okinawa-ai-beach-robot/beach-cleaning-hardware/components/gripper/Flexible robotic gripper/servo_spec.webp

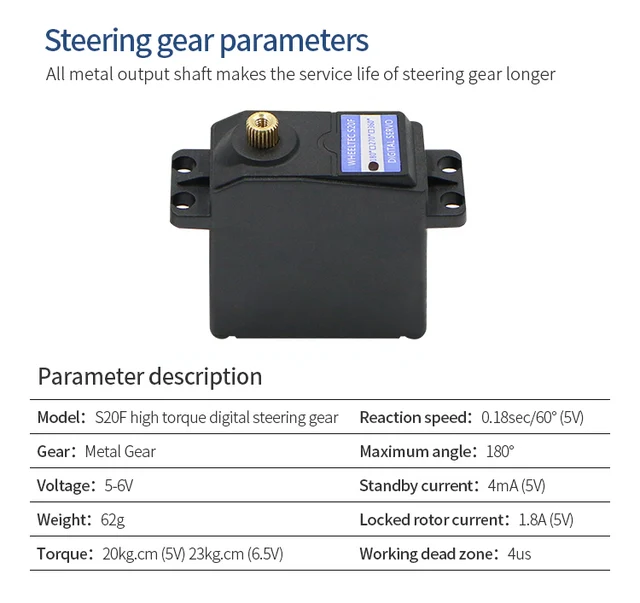
components/gripper/Flexible robotic gripper/servo_spec.webp
