okinawa-ai-beach-robot/beach-cleaning-hardware/components/gripper/Flexible robotic gripper/Steering machine version electronic control description.jpg

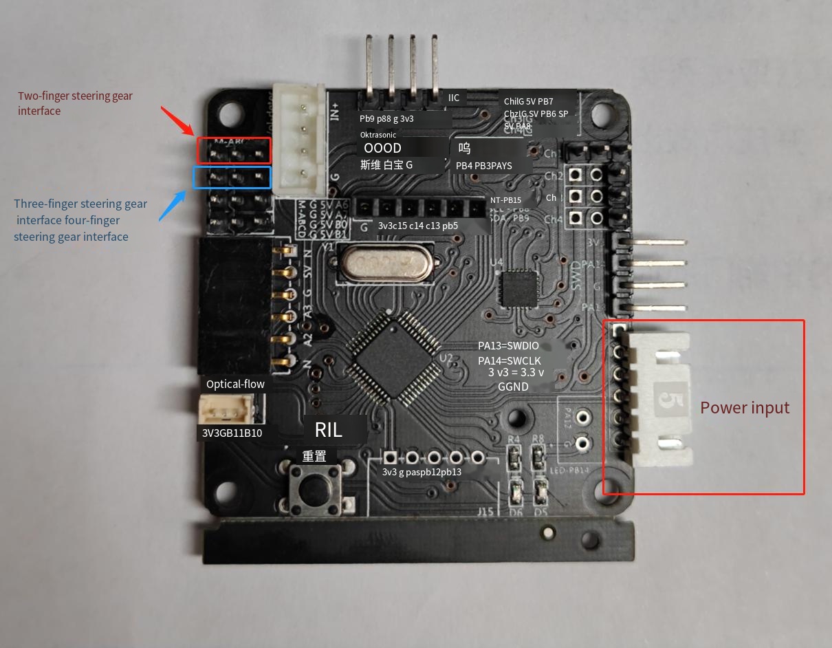
components/gripper/Flexible robotic gripper/Steering machine version electronic control description.jpg
