okinawa-ai-beach-robot/beach-cleaning-hardware/components/gripper/servointerface/digispark_intf_platformio/README.md

# Interface: Servo PWM to inflateable gripper

- This project simulates a servo input and generates motor signals for the inflatable gripper
- Project is made for a Digistump board
- For reference see comments in: [source file](src/digispark_intf.cpp)
- Open with PlatformIO (vscode plugin)
