okinawa-ai-beach-robot/beach-cleaning-hardware/components/arm_RoArm-M1/roarm-m1-custom-firmware/angleinfo.txt

config pose:
{"A1":179.6484375,"T1":-32,"A2":74.0625,"T2":64,"A3":-5.361328125,"T3":48,"A4":0.703125,"T4":-64,"A5":68.46679688,"T5":0}

Joint control init pose:
{"A1":179.7363281,"T1":-32,"A2":0.17578125,"T2":56,"A3":90.17578125,"T3":24,"A4":89.03320313,"T4":96,"A5":68.90625,"T5":0}
