okinawa-ai-beach-robot/beach-cleaning-hardware/components/arm_RoArm-M1/RoArm-M1-Waveshare-Wiki.pdf

RoArm-M

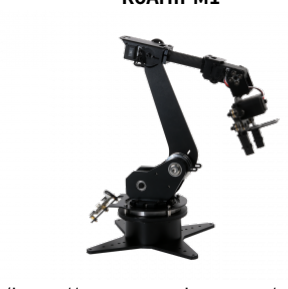
[picture p4: figure]

(https://www.waveshare.com/roarm-m.htm) (https://www.waveshare.com/roarm-m1.htm)

TTL serial bus servo control interface, UART

# RoArm-M

From Waveshare Wiki
Jump to: navigation, (https://www.waveshare.com/wiki/RoArm-M1#mw-navigation) search (https://www.waveshare.com/wiki/RoArm-M1#p-search)

## Introduction

RoArm-M is a mechanical arm based on the ESP series structure, including the clamping freedom of the gripper. This product has a total of degrees of freedom, all of which are driven by a kg.cm high-torque ST serial bus servo. Each servo can feed back the current joint voltage, position, current, temperature, load, and other information. And the big arm adopts a : reduction group with timing pulleys, which greatly improves the effective torque of the mechanical arm on the one hand, and can be used to avoid damage to structural parts caused by excessive loads on the other hand.

Onboard WIFI, OLED screen, RGB-LED lights, and open source all product-related codes, including the underlying serial bus servo control function library, serial communication control functions, cross-platform WEB control functions, inverse kinematics, ROS demos, URDF models, etc.

The demo contains a variety of control methods: angle control mode, inverse kinematics coordinate control mode, recording action and
replaying action, and leading-following control mode based on ESP-NOW communication protocol.

RoArm-M can support a variety of host computers, as long as it is connected to the host computer via a USB cable. The host computer can be a PC, Raspberry Pi, Jetson Nano, or other devices, and the data in JSON format can be sent and received via the USB serial port to control the robotic arm or get feedback from a robotic arm.

## Features

- RoArm-M is a serial robotic arm with -DOF in total, including the clamping freedom of the gripper.
- Open-source demo includes angle control and coordinates control.
- The lower computer demo contains open source inverse kinematics algorithm.
- Supports leading-following mode based on ESP-NOW.
- Supports motion recording and replaying control mode.
- Based on ESP, supports WIFI and UART communication.
- The open-source demos include WEB applications that can be used across platforms. You only need to install a browser to use mobile phones, tablets, and computers to control the robotic arm.
- Supports multiple host computers, and provides ROS demo and other rich learning resources.
- Cameras can be installed on the gripper of the robotic arm.
- All codes are open-source, and we provide rich online development documents and tutorials.

## Video

- RoArm-M show:

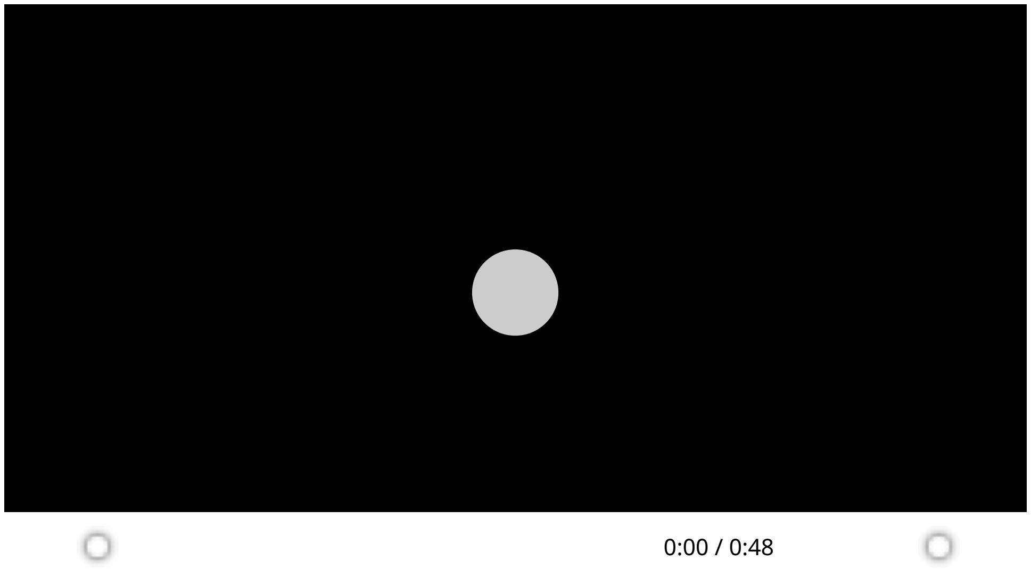
[picture p5: figure]

## RoArm-M Tutorial Directory

Please be sure to understand the following before use:
. This product has been assembled before leaving the factory, but due to the use of a large number of servos, once it is disassembled and then reassembled, it must be assembled and calibrated according to the product assembly tutorial.
. The torque of the servos used in this product is relatively large, so it may bring potential risks. When using it, keep sensitive parts such as eyes away from the range of motion of the servos, and keep them away from children to avoid injury.
. Some joints use green nitrile rubber O-rings to eliminate the virtual position error and vibration of the joints. It is normal for some rubber debris to fall off during use, and it will not continue to shed debris after it is run in.
. For the sake of safety, the robot arm of the default demo runs at a relatively slow speed. You can refer to the secondary development tutorial to change this speed. Too low speed may cause the robot arm to vibrate when it moves to some specific positions.
- RoArm-M Tutorial I: How To Use (/wiki/RoArm-M_Tutorial_I:_How_To_Use) (https://www.waveshare.com/wiki/RoArm-M1_Tutorial_I:_How_To_Use)
- RoArm-M Tutorial II: Secondary Development Tutorial (/wiki/RoArm-M_Tutorial_II:_Secondary_Development_Tutorial) (https://www.waveshare.com/wiki/RoArm-M1_Tutorial_II:_Secondary_Development_Tutorial)
- RoArm-M Tutorial III: VMware ROS Getting Started Tutorial (/wiki/RoArm-M_Tutorial_III:_VMware_ROS_Getting_Started_Tutorial) (https://www.waveshare.com/wiki/RoArm-M1_Tutorial_III:_VMware_ROS2_Getting_Started_Tutorial)
- RoArm-M Tutorial IV: URDF Model Tutorial (/wiki/RoArm-M_Tutorial_IV:_URDF_Model_Tutorial) (https://www.waveshare.com/wiki/RoArm-M1_Tutorial_IV:_URDF_Model_Tutorial)
- RoArm-M Tutorial V: ROS Serial Communication Node (/wiki/RoArm-M_Tutorial_V:_ROS_Serial_Communication_Node) (https://www.waveshare.com/wiki/RoArm-M1_Tutorial_V:_ROS2_Serial_Communication_Node)
- RoArm-M Tutorial VI: How to assemble RoArm-M (/wiki/RoArm-M_Tutorial_VI:_How_to_assemble_RoArm-M) (https://www.waveshare.com/wiki/RoArm-M1_Tutorial_VI:_How_to_assemble_RoArm-M1)
- RoArm-M Tutorial VII: Assembly Graphics Tutorial (/wiki/RoArm-M_Tutorial_VII:_Assembly_Graphics_Tutorial) (https://www.waveshare.com/wiki/RoArm-M1_Tutorial_VII:_Assembly_Graphics_Tutorial)
- RoArm-M Tutorial VIII: Use of rqt in ROS (/wiki/RoArm-M_Tutorial_VIII:_Use_of_rqt_in_ROS) (https://www.waveshare.com/wiki/RoArm-M1_Tutorial_VIII:_Use_of_rqt_in_ROS2)

- RoArm-M Tutorial IV: URDF Model Tutorial (/wiki/RoArm-M_Tutorial_IV:_URDF_Model_Tutorial) (https://www.waveshare.com/wiki/RoArm-M1_Tutorial_IV:_URDF_Model_Tutorial)
- RoArm-M Main Page

# Resource

## Drawing

- Dimensions (https://files.waveshare.com/upload/b/bf/RoArm-M_%E%B%BA%E%AF%B%E%B%BE.pdf)

## VirtualBox ROS Image

- VirtualBox ROS Image (https://drive.google.com/file/d/FDYaLkfqjxyAmPAcw-Qp/view?usp=sharing) (https://drive.google.com/file/d/1F0D1201YaLkf1q8jxy54Am72PAcw8-Qp/view?usp=sharing)
- Password: roarm

## URDF Open Source Model

- URDF Open Source Model (https://files.waveshare.com/upload//b/Roarm_urdf.zip) (https://files.waveshare.com/upload/1/1b/Roarm_urdf.zip)

## STEP Model

- STEP Model (https://files.waveshare.com/upload//a/RoArm-M_STEP.zip) (https://files.waveshare.com/upload/4/4a/RoArm-M1_STEP.zip)

## ROS Package

- ROS Package (https://files.waveshare.com/upload/f/fb/Roarm_ws.zip)

## Slave Device Open-source Demo

- Slave Device Open-source Demo (https://files.waveshare.com/upload//a/RoArm-M-ESP.zip) (https://files.waveshare.com/upload/4/4a/RoArm-M1-ESP32.zip)

## Open-source Resource

- .inch OLED Module Schematic (https://files.waveshare.com/upload//a/.inch_OLED_Module_Schematic.pdf) (https://files.waveshare.com/upload/2/2a/0.91inch_OLED_Module_Schematic.pdf)

# FAQ

Question:. During the installation process of ROS, there are many dependent libraries that cannot be downloaded? (https://www.waveshare.com/wiki/RoArm-M1#accordion1)

Answer:
You can refer to our tutorial to download the image file that has been configured with ROS.

Question:. Logitech mouse wheel not working in a virtual machine? (https://www.waveshare.com/wiki/RoArm-M1#accordion2)

Answer:
Open the Logitech mouse software and turn off smooth scrolling.

Question:. RViz display abnormal? (https://www.waveshare.com/wiki/RoArm-M1#accordion3)

Answer:
Turn off VMware's D graphics acceleration function.

Question:. After the virtual machine is powered on, there is only a terminal interface without a graphical interface? (https://www.waveshare.com/wiki/RoArm-M1#accordion4)

Answer:
Run sudo apt install ubuntu-desktop in the terminal, and sudo reboot to restart the virtual machine after the installation is complete.

# Support
