okinawa-ai-beach-robot/beach-cleaning-hardware/components/gripper/Flexible robotic gripper/Flexible adaptive gripper FA series.pdf

# Flexible adaptive gripper FA series brochure

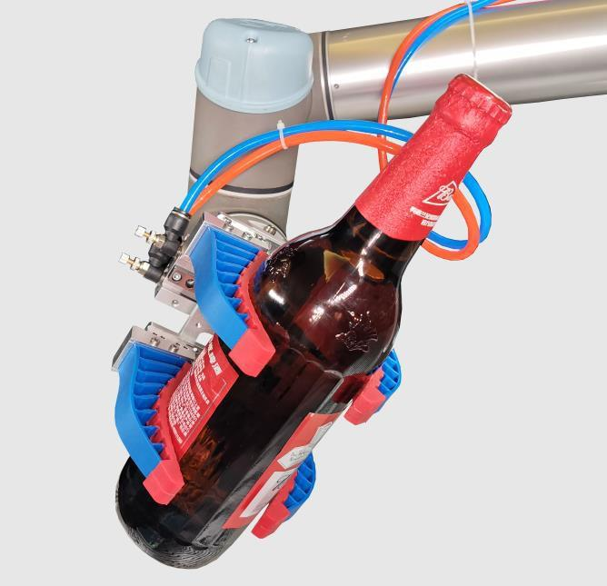
[picture p6: figure]

# Flexible adaptive gripper FA series introduce

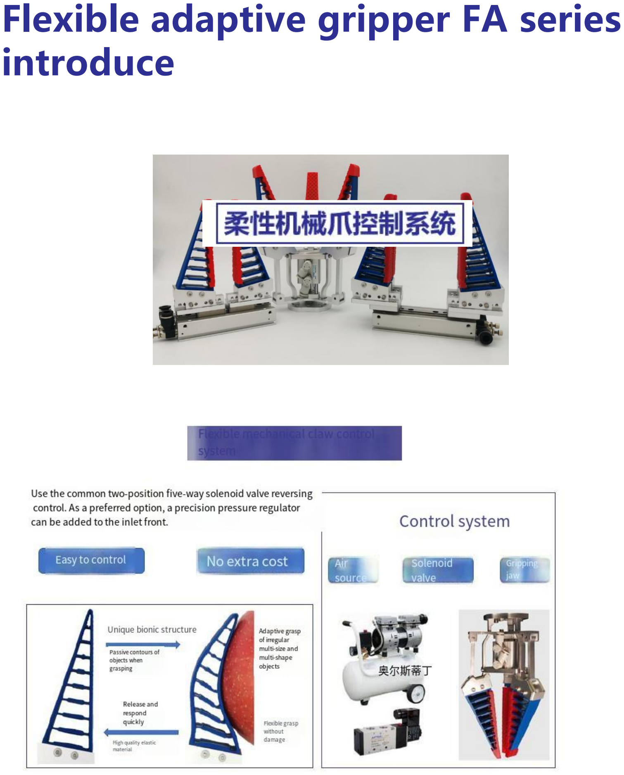
[picture p7: page 2]
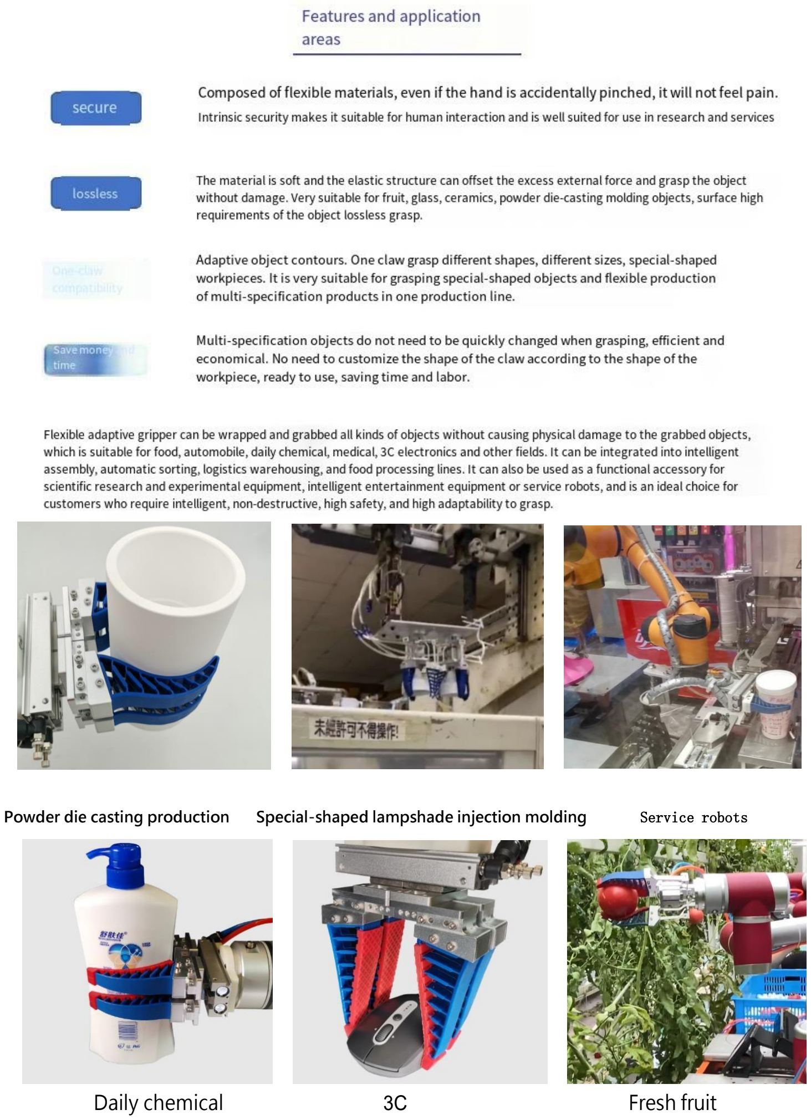
[picture p8: page 3]

Powder die casting production | Special-shaped lampshade injection molding | Service robots
Daily chemical | 3C | Fresh fruit

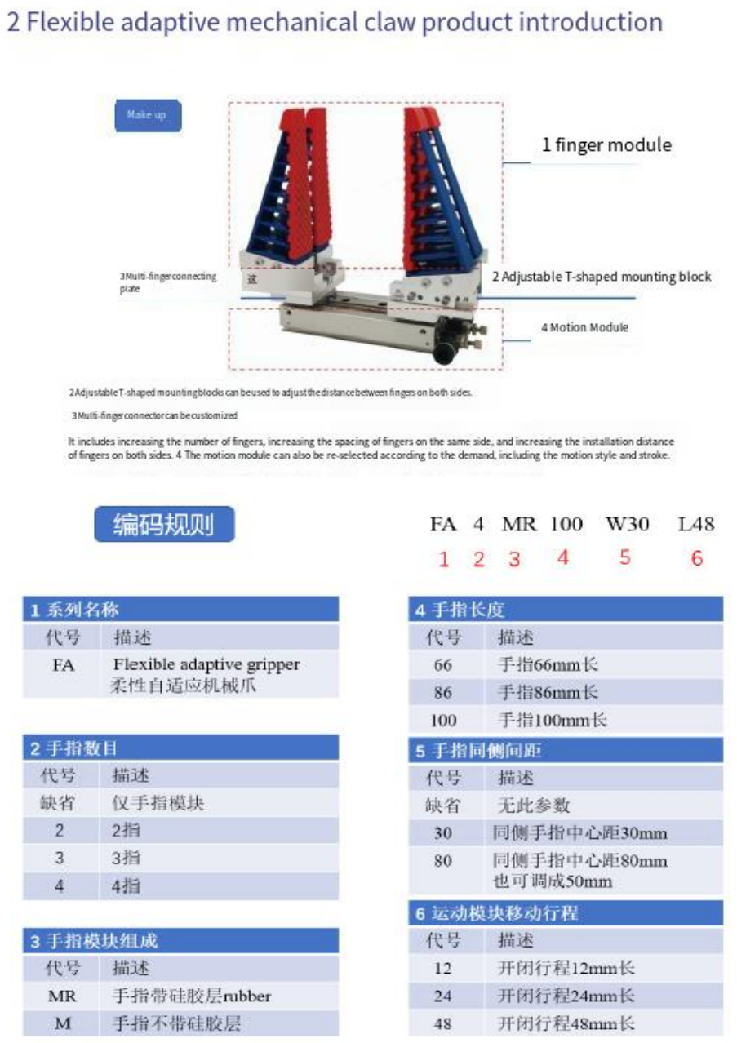
[picture p9: page 4]
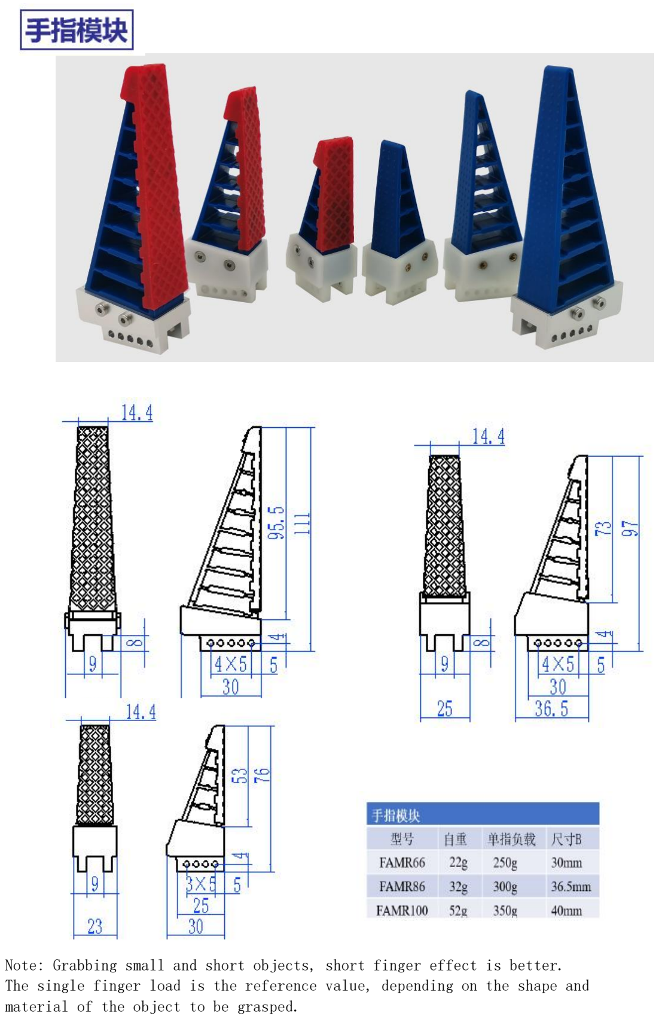
[picture p10: page 5]

Note: Grabbing small and short objects, short finger effect is better. The single finger load is the reference value, depending on the shape and material of the object to be grasped.

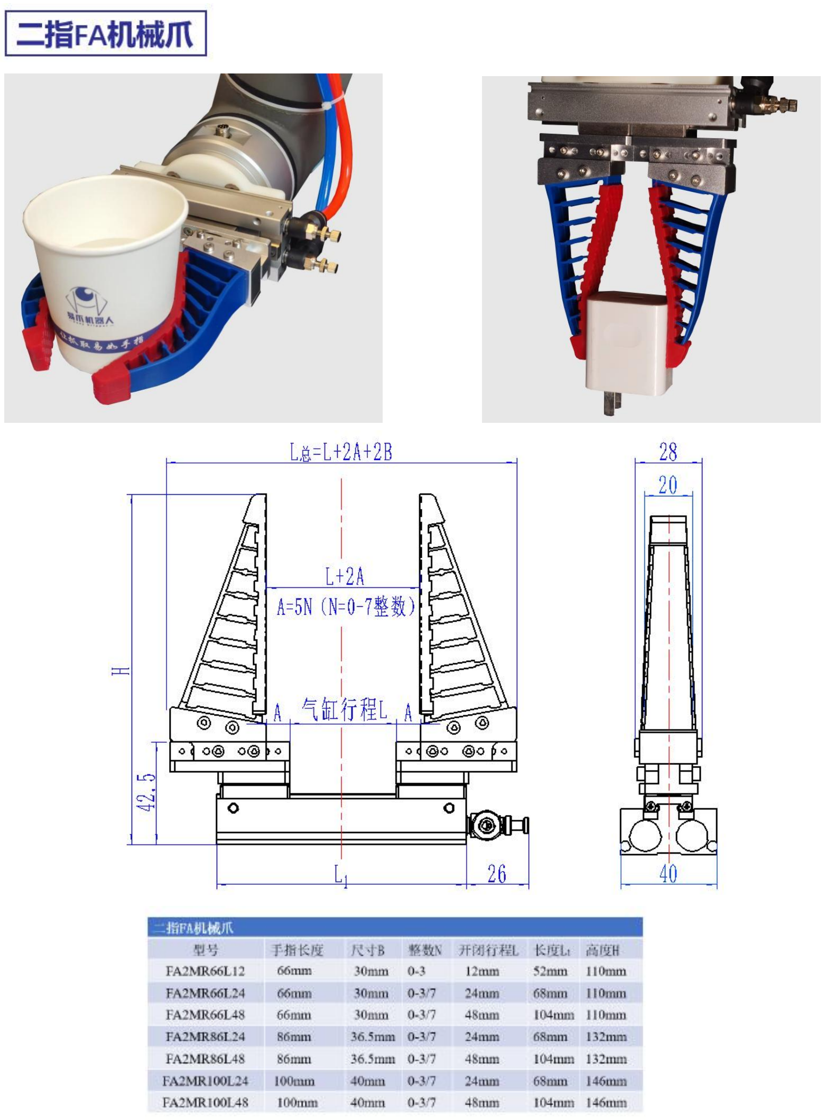
[picture p11: page 6]
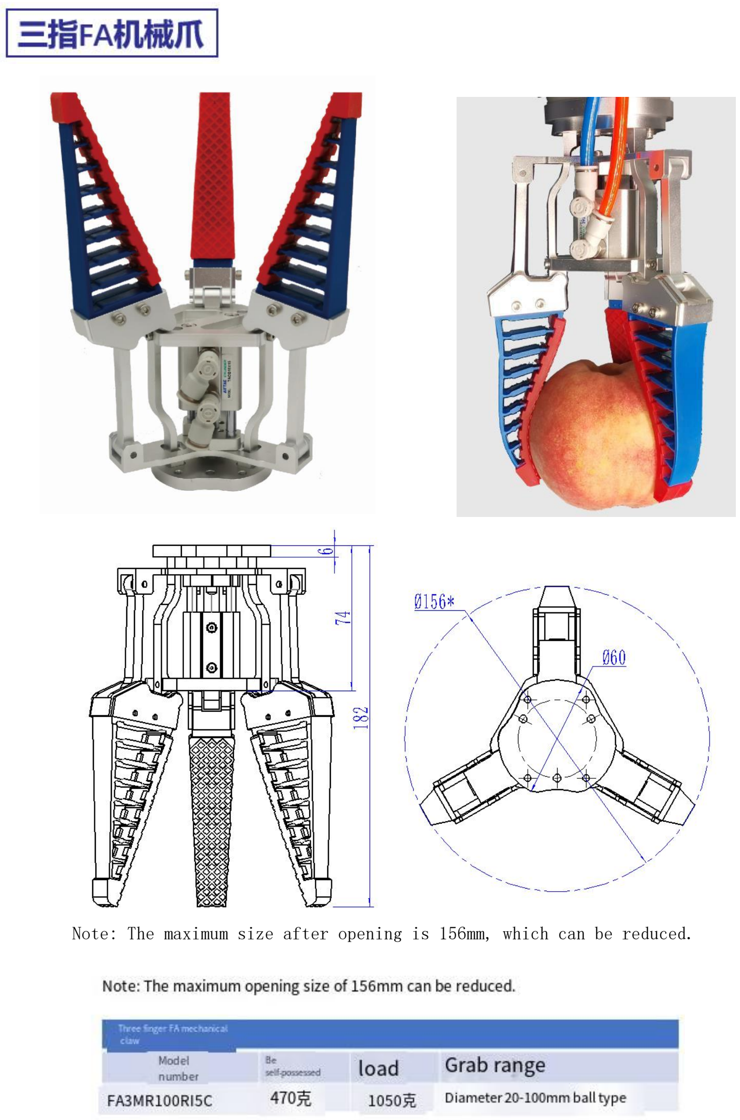
[picture p12: page 7]

Note: The maximum size after opening is 156mm, which can be reduced.

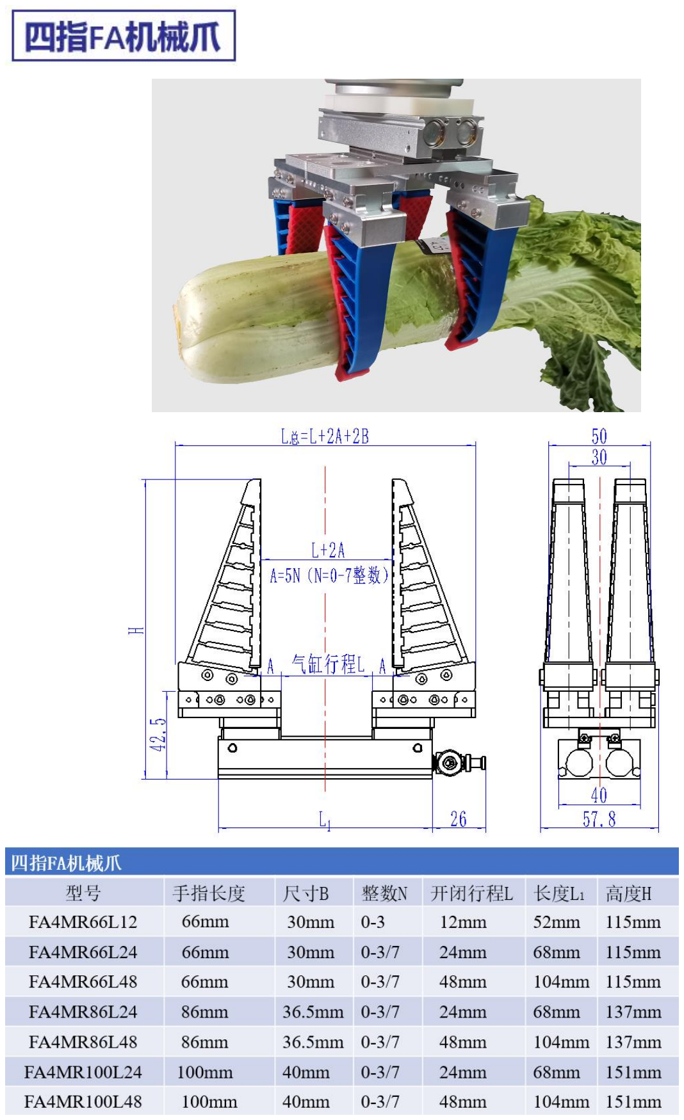
[picture p13: page 8]
