okinawa-ai-beach-robot/beach-cleaning-hardware/components/gripper/Flexible robotic gripper/5. 3D/Flexible adaptive gas refers to FA86/柔性自适应机械爪FA系列.docx

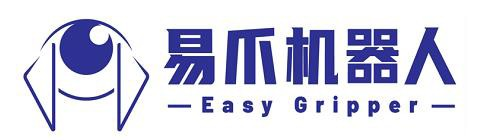
[picture p14: figure]
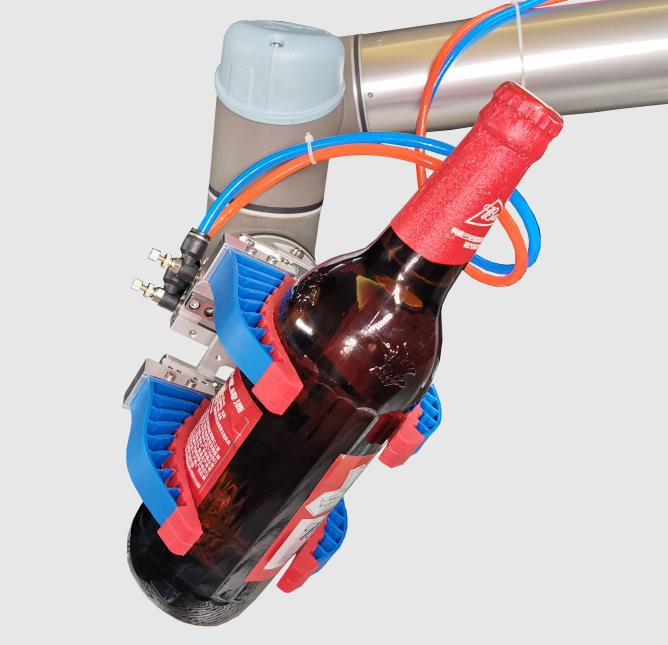
[picture p15: figure]

柔性自适应机械爪 FA 系列手册

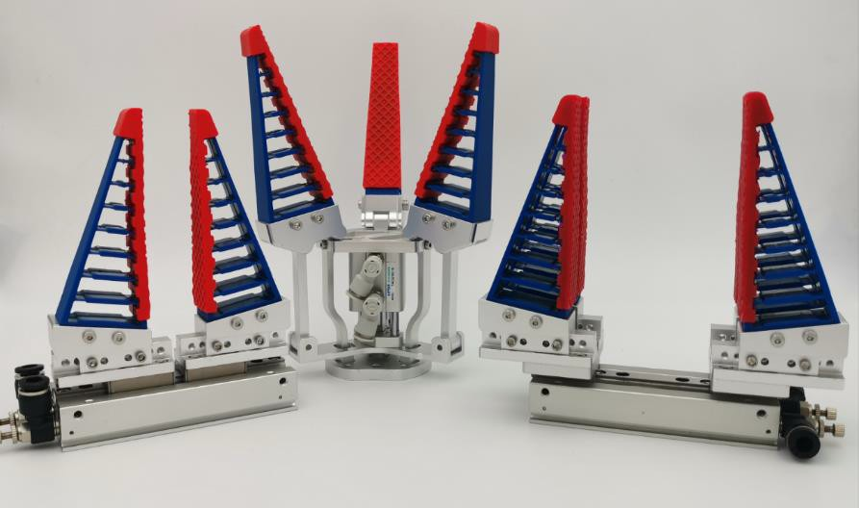
[picture p16: figure]
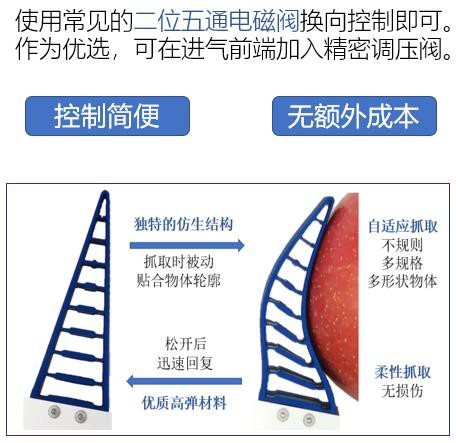
[picture p17: figure]
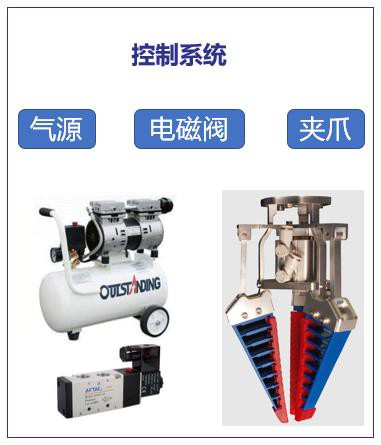
[picture p18: figure]
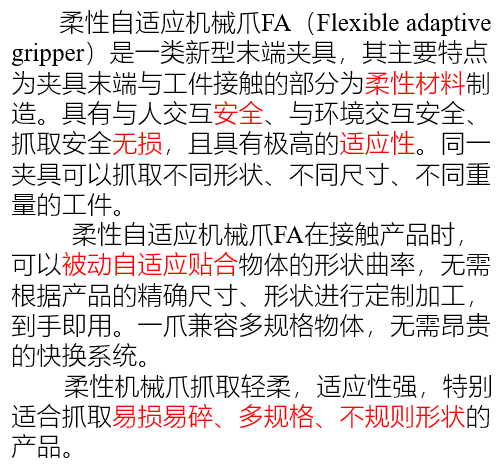
[picture p19: figure]
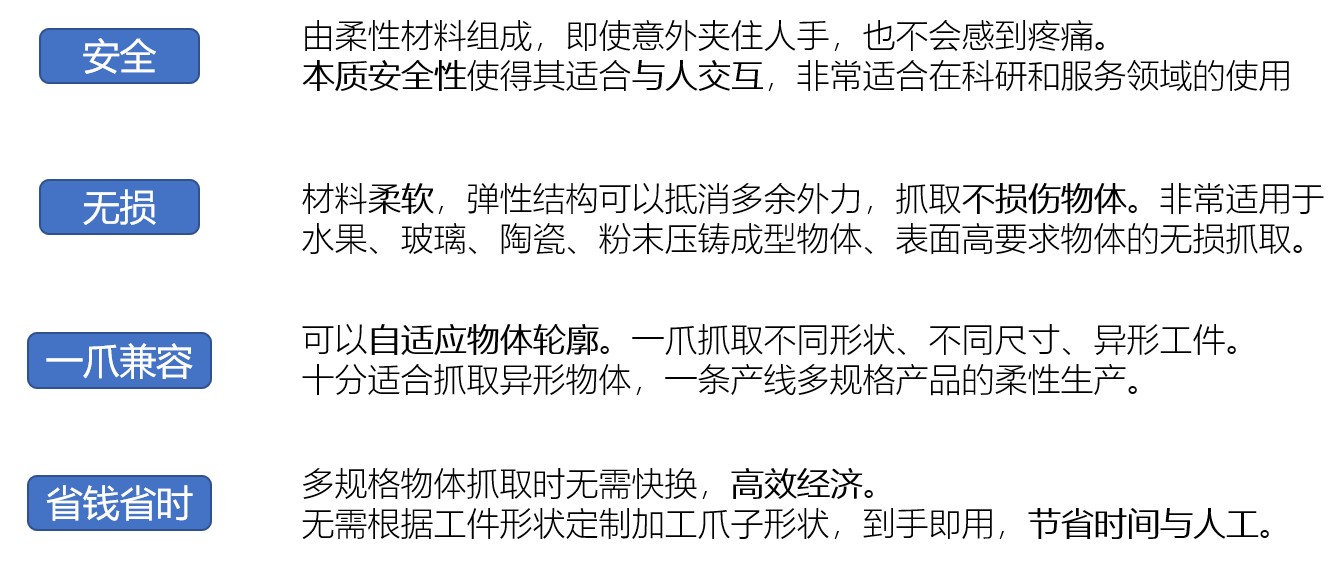
[picture p20: figure]
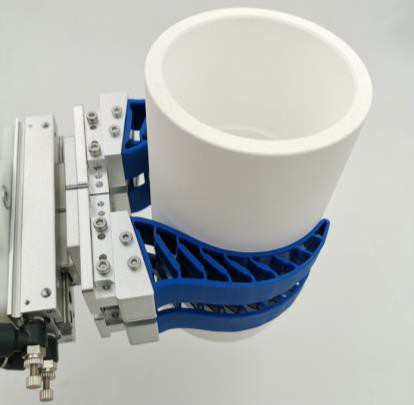
[picture p21: figure]
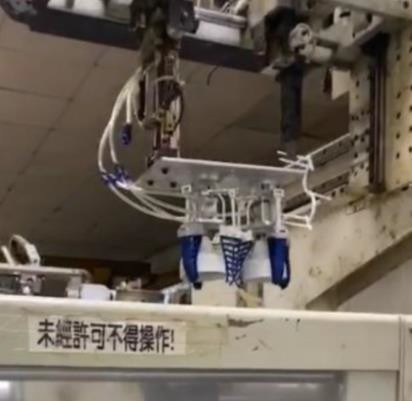
[picture p22: figure]
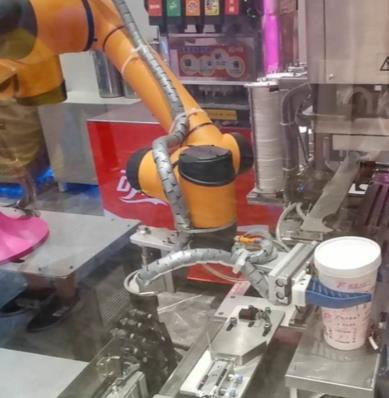
[picture p23: figure]

粉末压铸生产 异形灯罩注塑取模 服务机器人

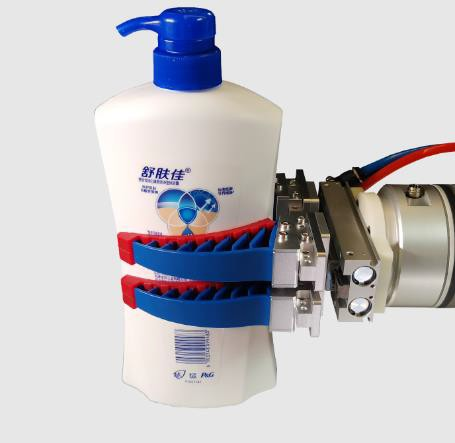
[picture p24: figure]
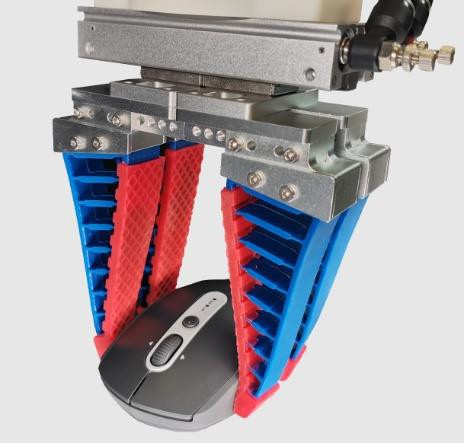
[picture p25: figure]
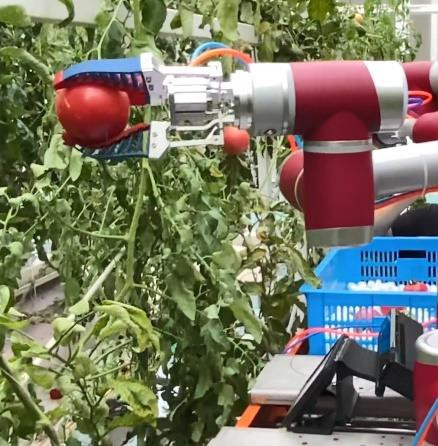
[picture p26: figure]

日化 3C 水果生鲜

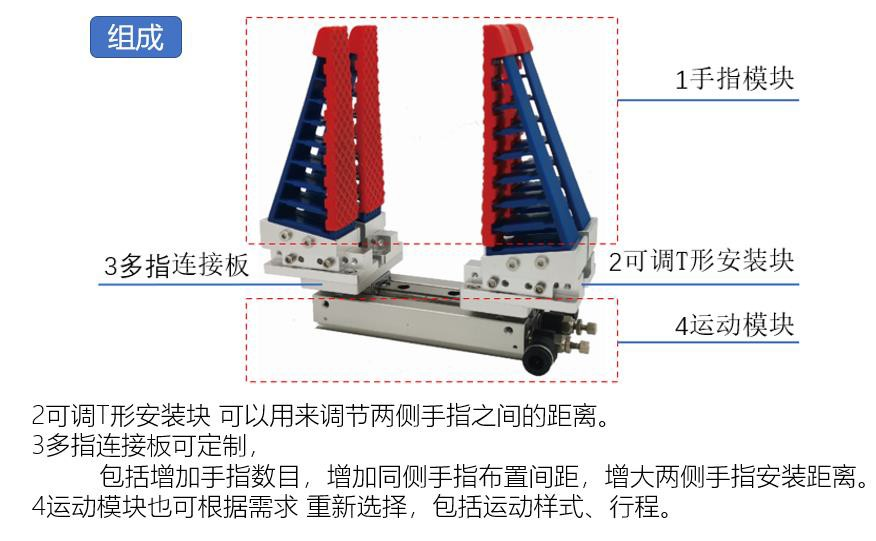
[picture p27: figure]
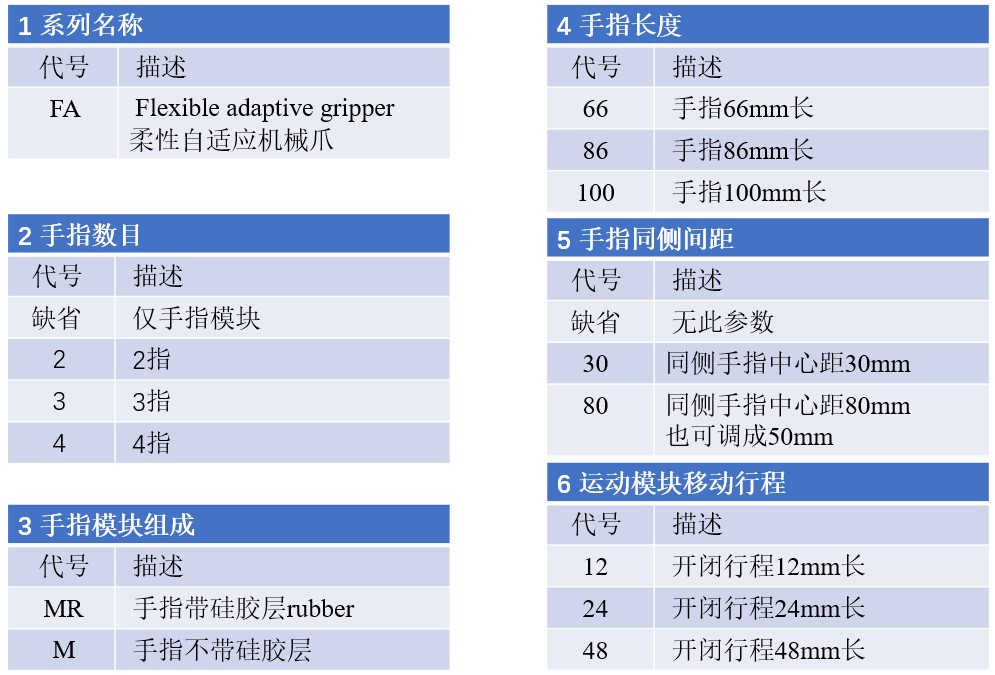
[picture p28: figure]
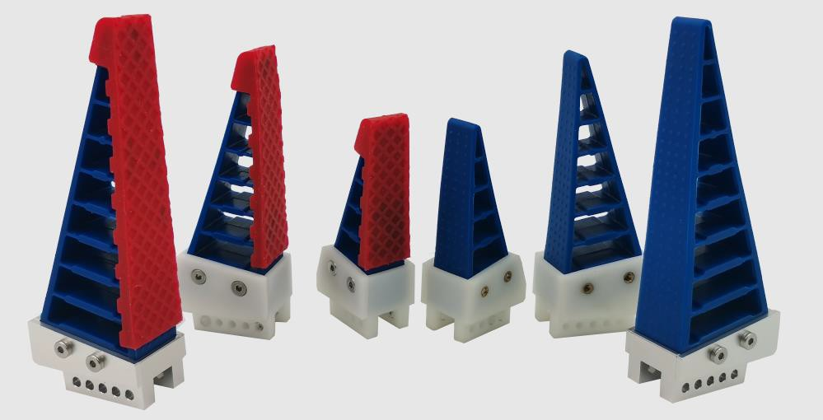
[picture p29: figure]
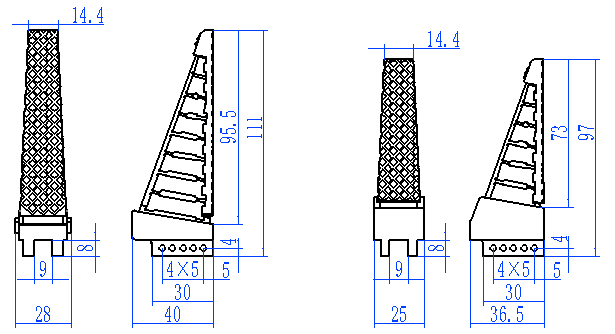
[picture p30: figure]
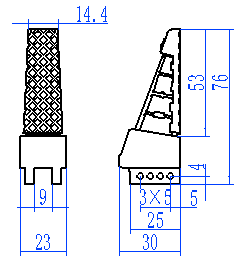
[picture p31: figure]
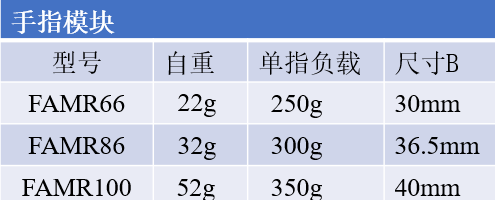
[picture p32: figure]

注：抓取小、矮物体，短指效果较好。

单指负载为参考值，视具体要抓取物体的形状、材料有所不同。

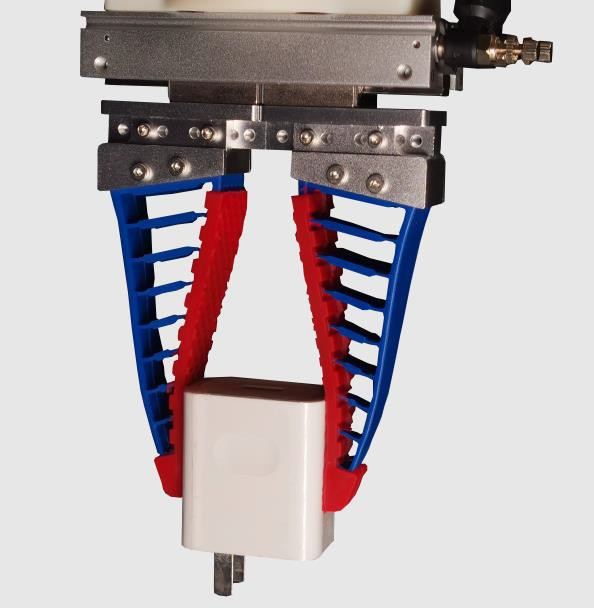
[picture p33: figure]
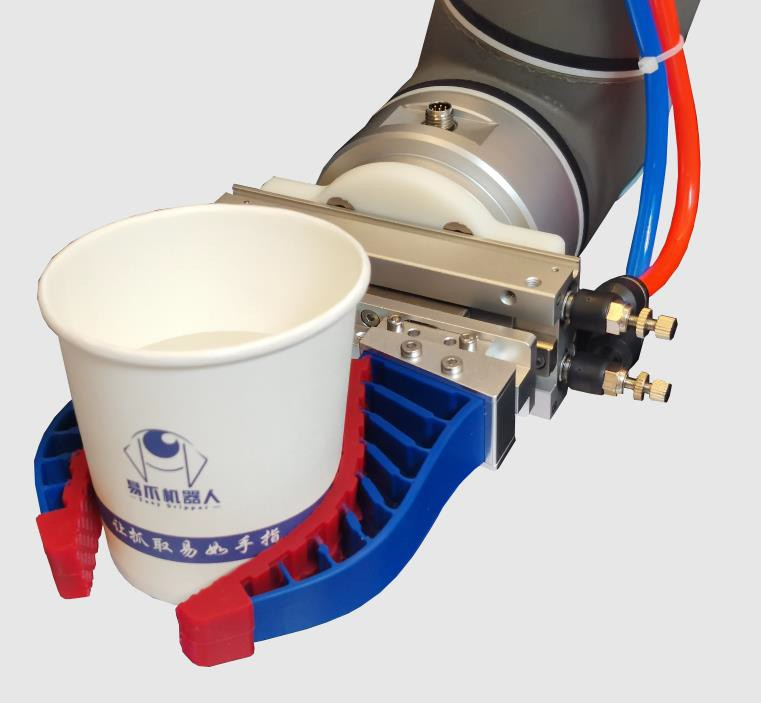
[picture p34: figure]
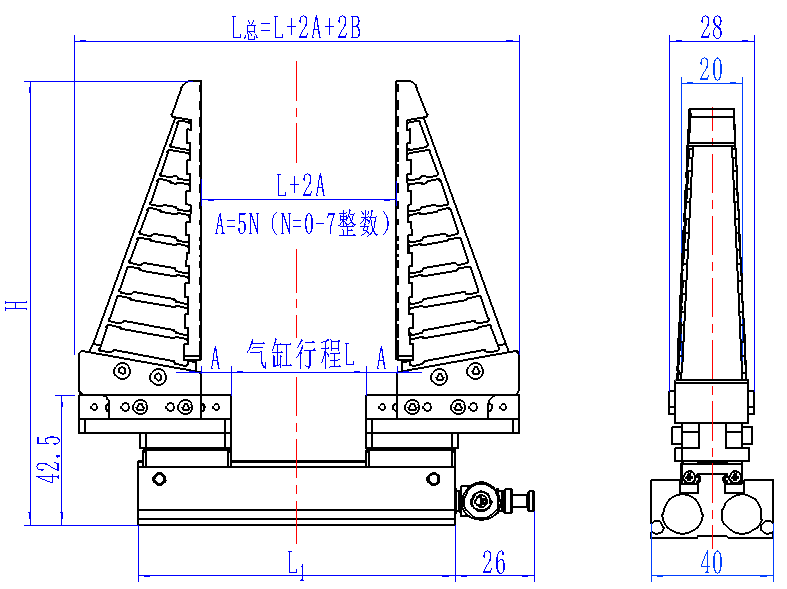
[picture p35: figure]
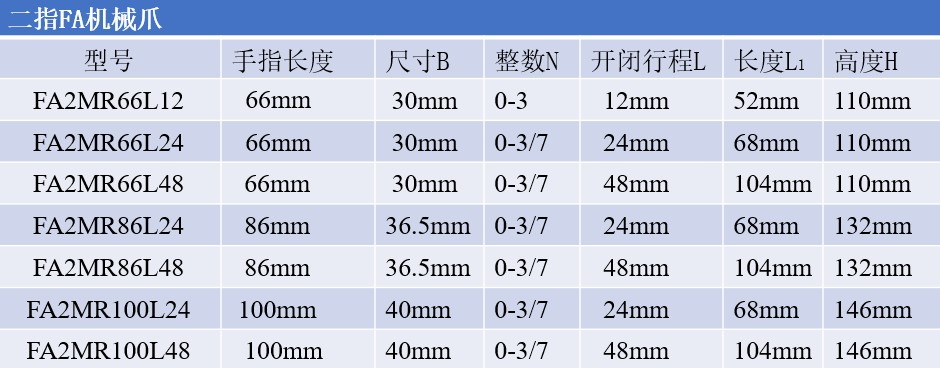
[picture p36: figure]
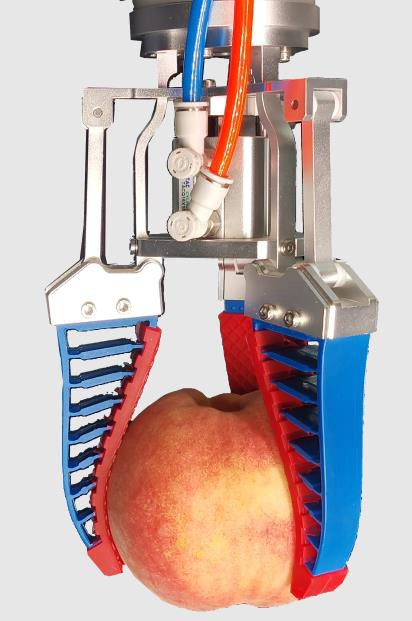
[picture p37: figure]
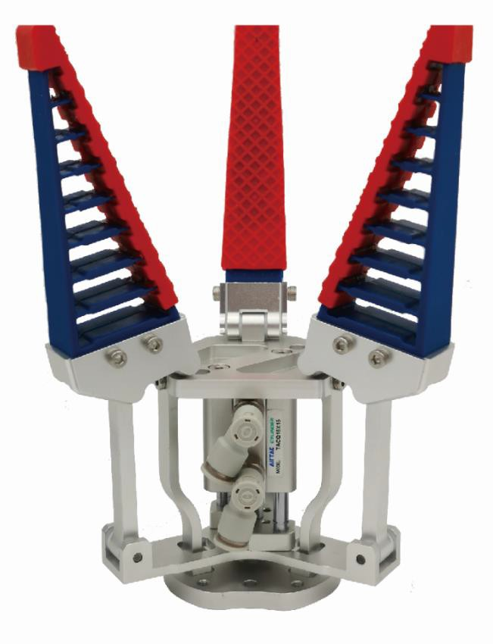
[picture p38: figure]
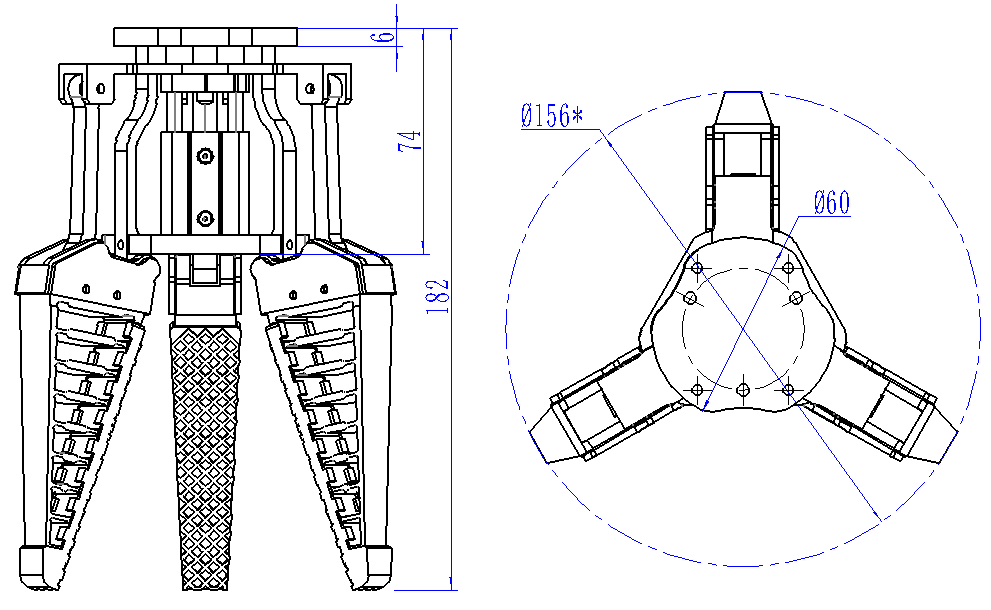
[picture p39: figure]

注：最大张开后尺寸 156mm 可以调小。

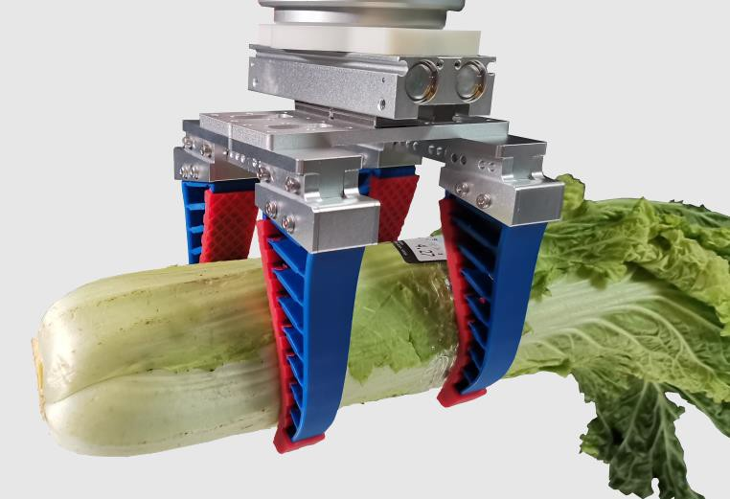
[picture p40: figure]
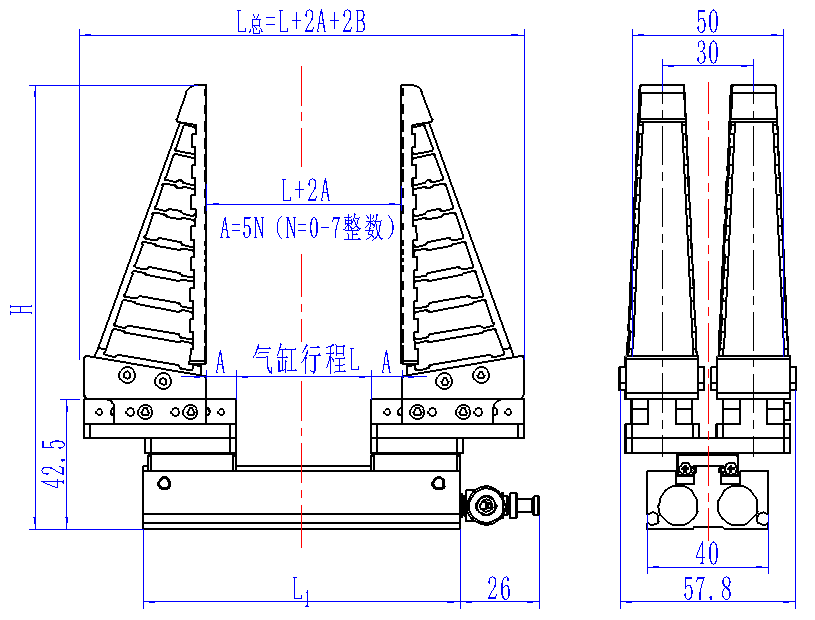
[picture p41: figure]
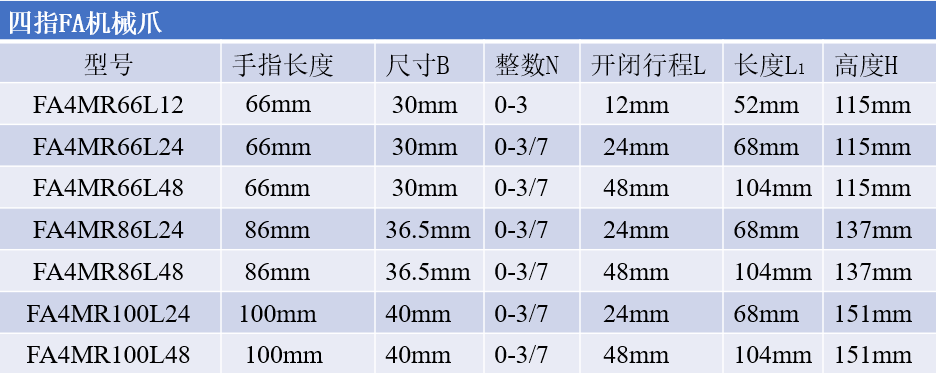
[picture p42: figure]
