okinawa-ai-beach-robot/beach-cleaning-hardware/components/camera-hbv-3m2111/OV3660-dimensions.webp

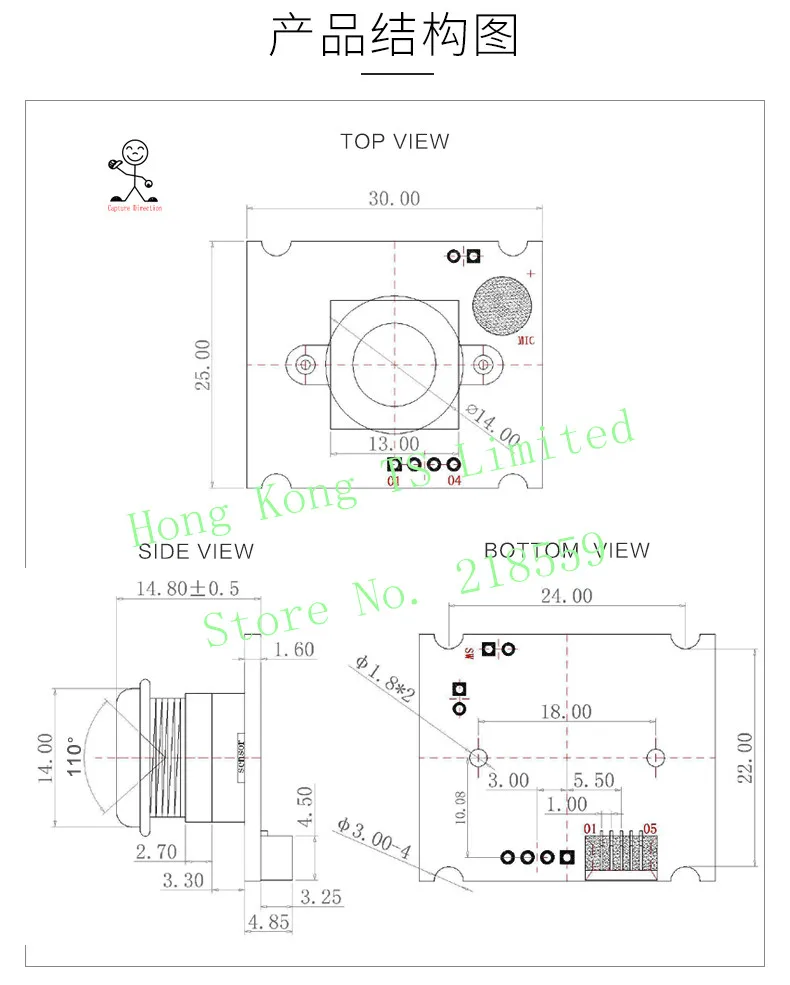
components/camera-hbv-3m2111/OV3660-dimensions.webp
