okinawa-ai-beach-robot/beach-cleaning-hardware/components/custom_gripper_parts/UMS5_3finger_camera.3mf

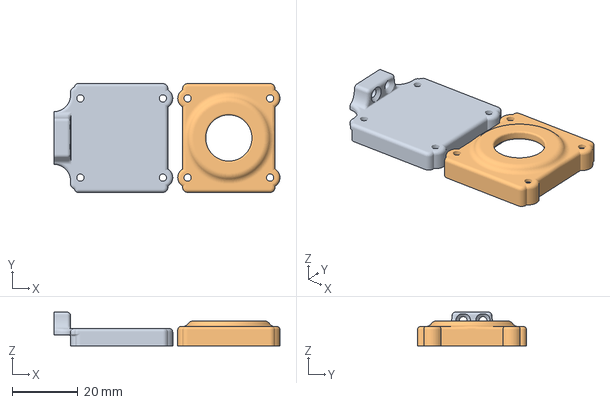
[picture p44: CAD file, 2024-04-10]
components/custom_gripper_parts/UMS5_3finger_camera.3mf
68.5 x 33.0 x 10.3 mm
adapter_3fingergripper_cameraA.stl
adapter_3fingergripper_cameraB.stl
