okinawa-ai-beach-robot/beach-cleaning-hardware/components/gripper/Flexible robotic gripper/5. 3D/Flexible adaptive gas refers to FA86/Flexible adaptive gas refers to FA86.stp

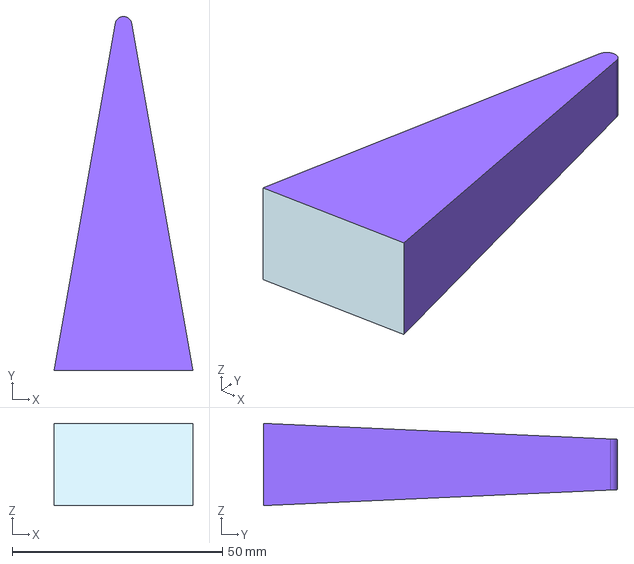
[picture p46: CAD file, 2024-02-16]
components/gripper/Flexible robotic gripper/5. 3D/Flexible adaptive gas refers to FA86/Flexible adaptive gas refers to FA86.stp
33.1 x 84.2 x 19.6 mm
