okinawa-ai-beach-robot/beach-cleaning-hardware/components/gripper/Flexible robotic gripper/5. 3D/Four-finger electric/Four-finger electric.stp

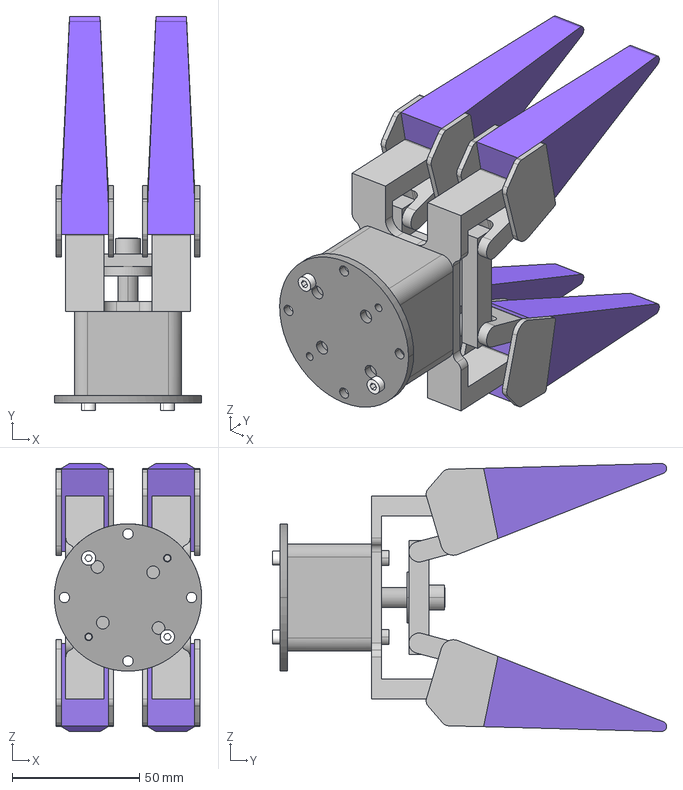
[picture p47: CAD file, 2024-02-16]
components/gripper/Flexible robotic gripper/5. 3D/Four-finger electric/Four-finger electric.stp
58.0 x 155.2 x 105.5 mm
