okinawa-ai-beach-robot/beach-cleaning-hardware/components/gripper/Flexible robotic gripper/5. 3D/Four-finger pneumatics/Four-finger pneumatics.stp

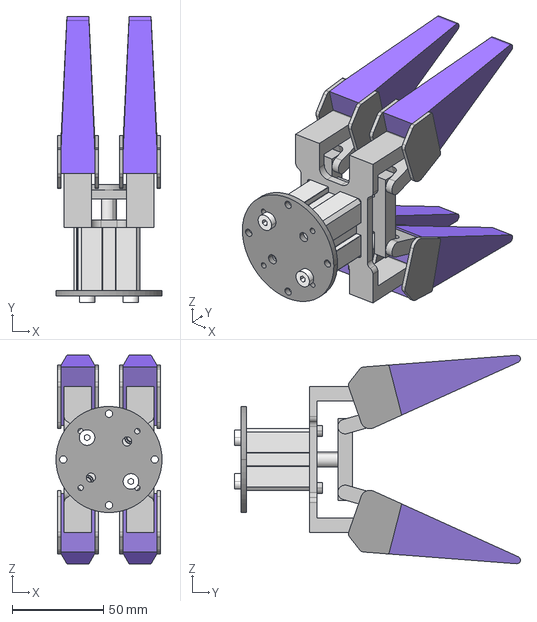
[picture p49: CAD file, 2024-02-16]
components/gripper/Flexible robotic gripper/5. 3D/Four-finger pneumatics/Four-finger pneumatics.stp
58.0 x 156.3 x 114.0 mm
