okinawa-ai-beach-robot/beach-cleaning-hardware/components/gripper/Flexible robotic gripper/5. 3D/Spherical universal gripper BU60/Spherical universal gripper BU60.IGS

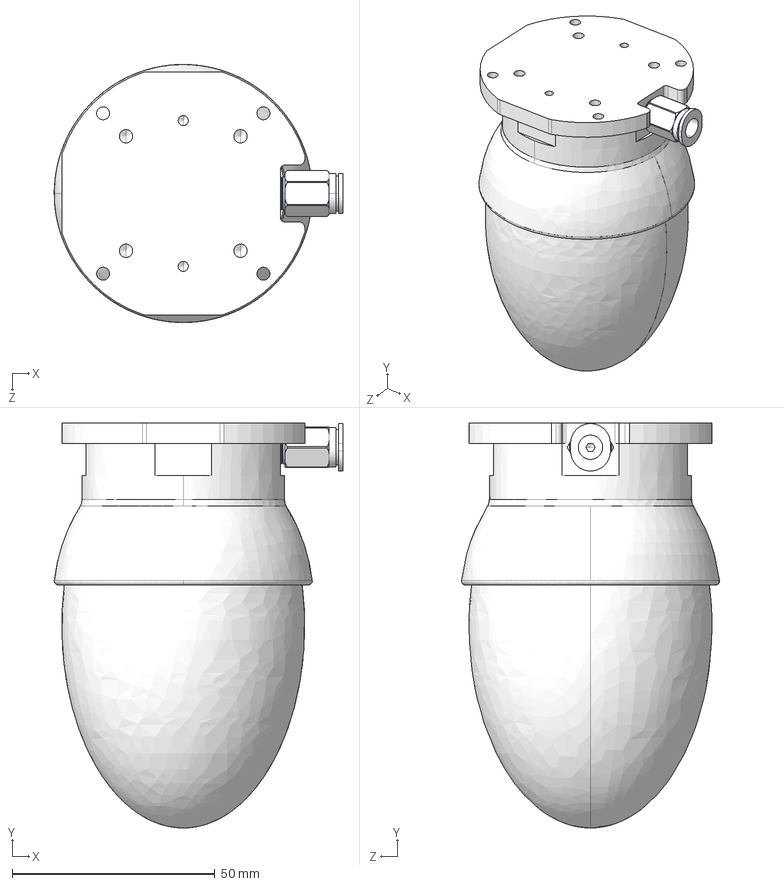
[picture p50: CAD file, 2024-02-16]
components/gripper/Flexible robotic gripper/5. 3D/Spherical universal gripper BU60/Spherical universal gripper BU60.IGS
71.3 x 100.0 x 63.8 mm
