okinawa-ai-beach-robot/beach-cleaning-hardware/components/gripper/Flexible robotic gripper/5. 3D/Three-finger electric/Three-finger electric.stp

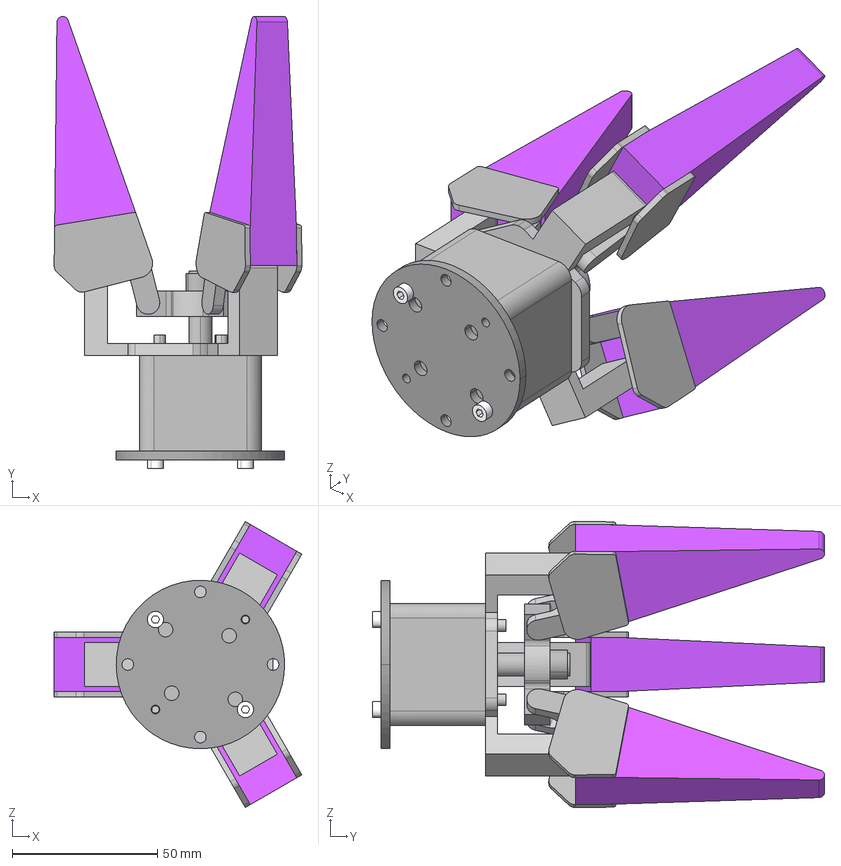
[picture p51: CAD file, 2024-02-16]
components/gripper/Flexible robotic gripper/5. 3D/Three-finger electric/Three-finger electric.stp
85.3 x 155.7 x 98.5 mm
