okinawa-ai-beach-robot/beach-cleaning-hardware/components/gripper/Flexible robotic gripper/5. 3D/Three-finger pneumatics/Three-finger pneumatics.stp

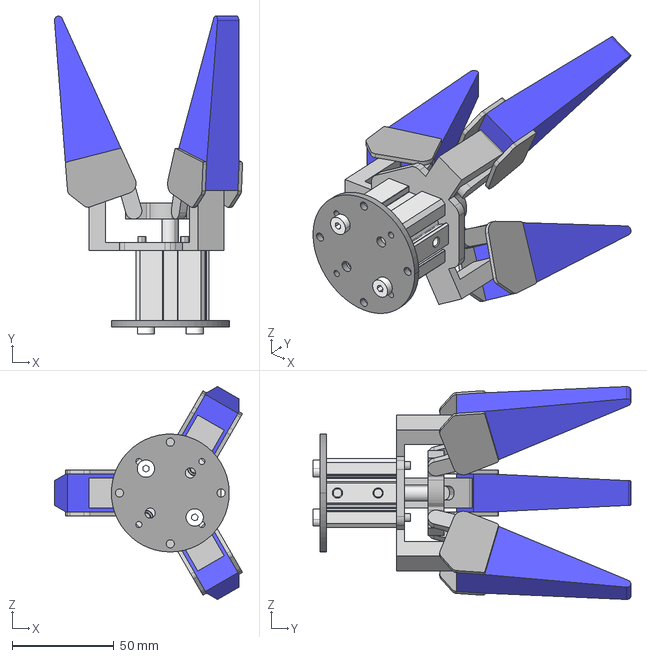
[picture p52: CAD file, 2024-02-16]
components/gripper/Flexible robotic gripper/5. 3D/Three-finger pneumatics/Three-finger pneumatics.stp
92.5 x 156.3 x 104.8 mm
