okinawa-ai-beach-robot/beach-cleaning-hardware/components/gripper/Flexible robotic gripper/5. 3D/Three-finger servo/Three-finger servo.stp

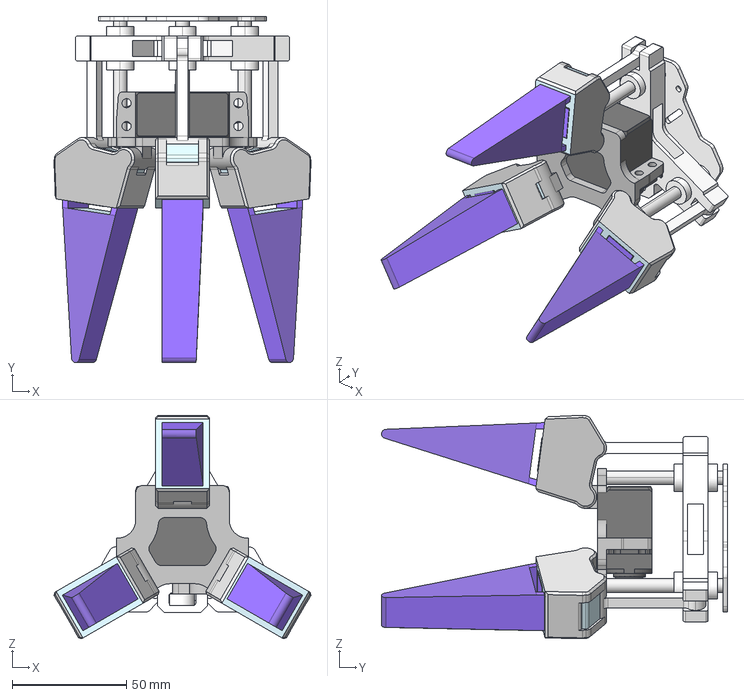
[picture p53: CAD file, 2024-02-16]
components/gripper/Flexible robotic gripper/5. 3D/Three-finger servo/Three-finger servo.stp
112.6 x 151.6 x 97.9 mm
