okinawa-ai-beach-robot/beach-cleaning-hardware/components/gripper/Flexible robotic gripper/5. 3D/Two fingers electric/Two fingers electric.stp

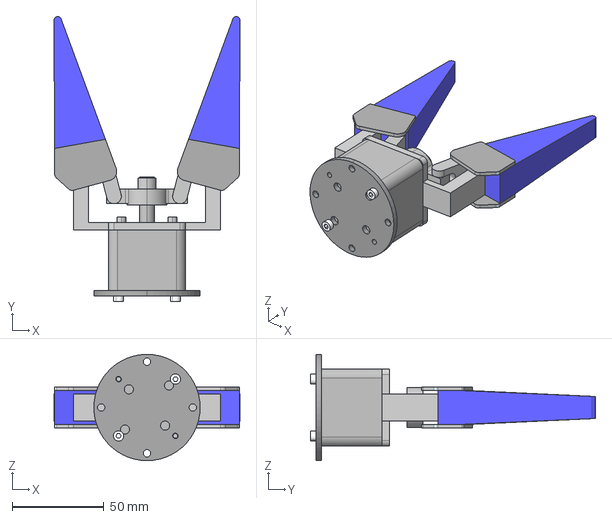
[picture p54: CAD file, 2024-02-16]
components/gripper/Flexible robotic gripper/5. 3D/Two fingers electric/Two fingers electric.stp
101.5 x 155.5 x 58.0 mm
