okinawa-ai-beach-robot/beach-cleaning-hardware/components/gripper/Flexible robotic gripper/5. 3D/Two-finger pneumatics/Two-finger pneumatics.stp

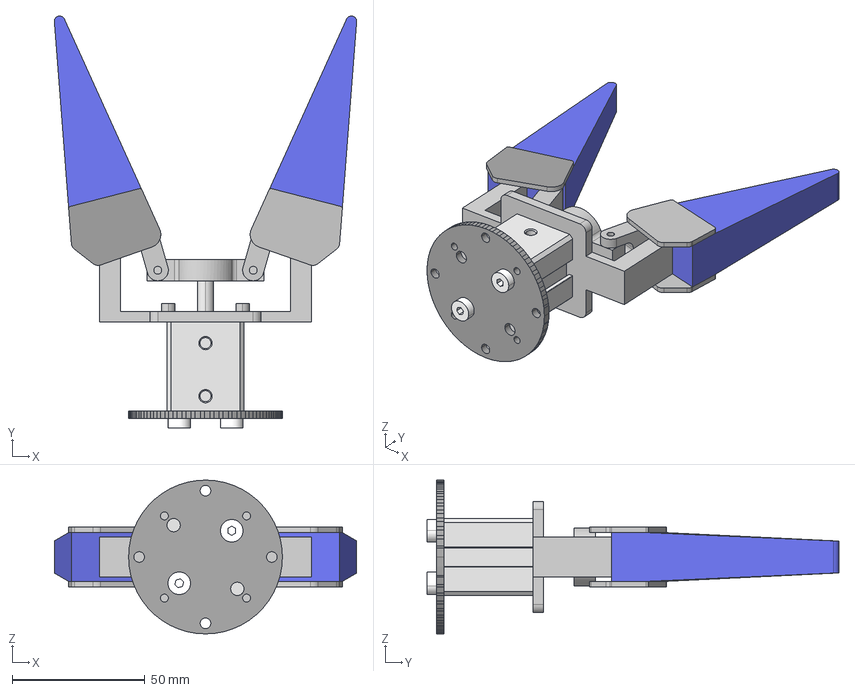
[picture p55: CAD file, 2024-02-16]
components/gripper/Flexible robotic gripper/5. 3D/Two-finger pneumatics/Two-finger pneumatics.stp
114.0 x 155.3 x 58.0 mm
