okinawa-ai-beach-robot/beach-cleaning-hardware/components/gripper/Flexible robotic gripper/5. 3D/Two-finger servo/Two-finger servo.stp

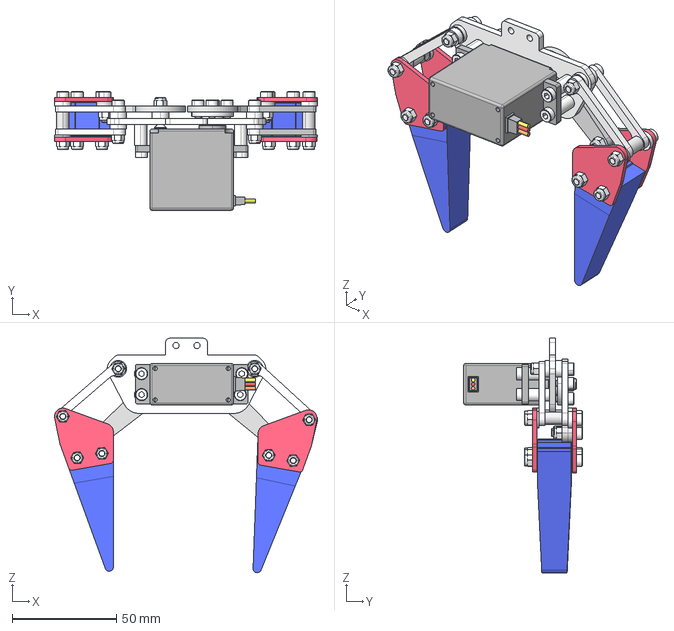
[picture p56: CAD file, 2024-02-16]
components/gripper/Flexible robotic gripper/5. 3D/Two-finger servo/Two-finger servo.stp
126.0 x 56.8 x 112.4 mm
