okinawa-ai-beach-robot/beach-cleaning-hardware/components/servos/mounting_bracket.step

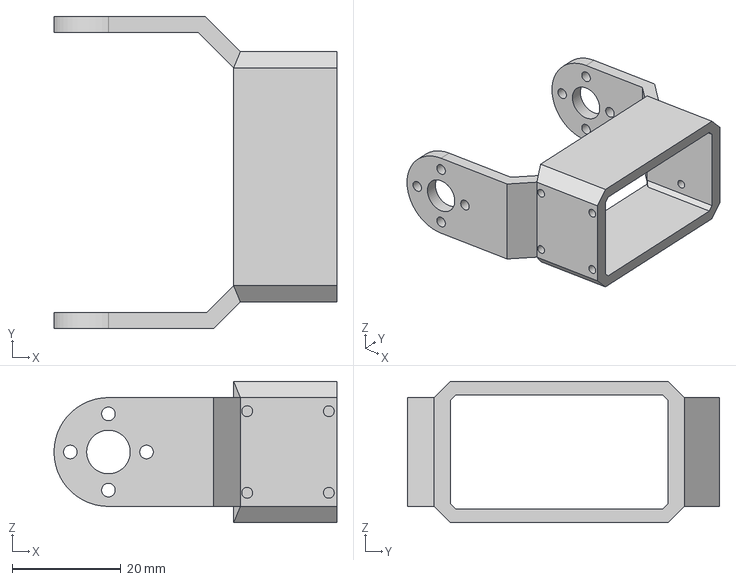
[picture p57: CAD file, 2024-02-08]
components/servos/mounting_bracket.step
52.0 x 57.4 x 26.0 mm
