okinawa-ai-beach-robot/beach-cleaning-hardware/components/support_frame_solar_length.FCStd

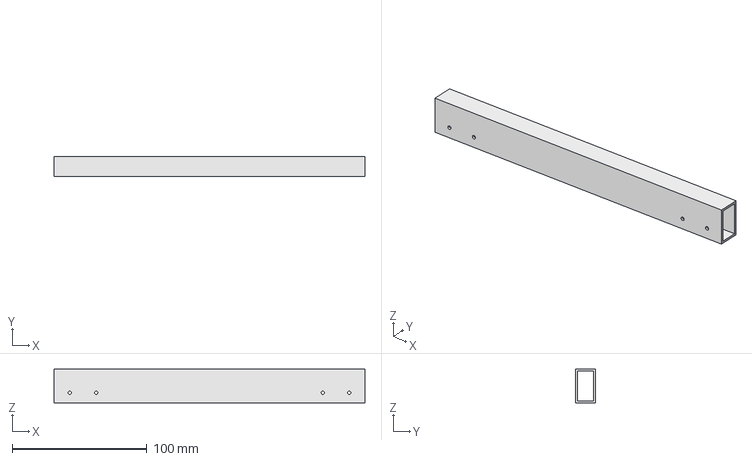
[picture p58: CAD file, 2024-03-28]
components/support_frame_solar_length.FCStd
231.0 x 15.0 x 25.0 mm
