okinawa-ai-beach-robot/beach-cleaning-hardware/components/custom_gripper_parts/adapter_3fingergripper_cameraA.stl

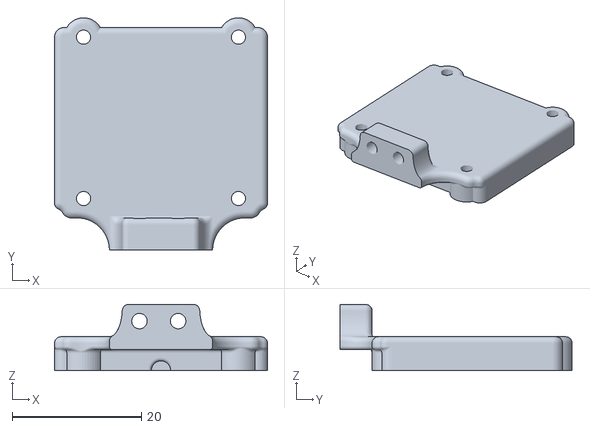
[picture p59: CAD file, 2024-04-10]
components/custom_gripper_parts/adapter_3fingergripper_cameraA.stl
33.0 x 36.0 x 10.2
