okinawa-ai-beach-robot/beach-cleaning-hardware/components/support_frame_solar_width.FCStd

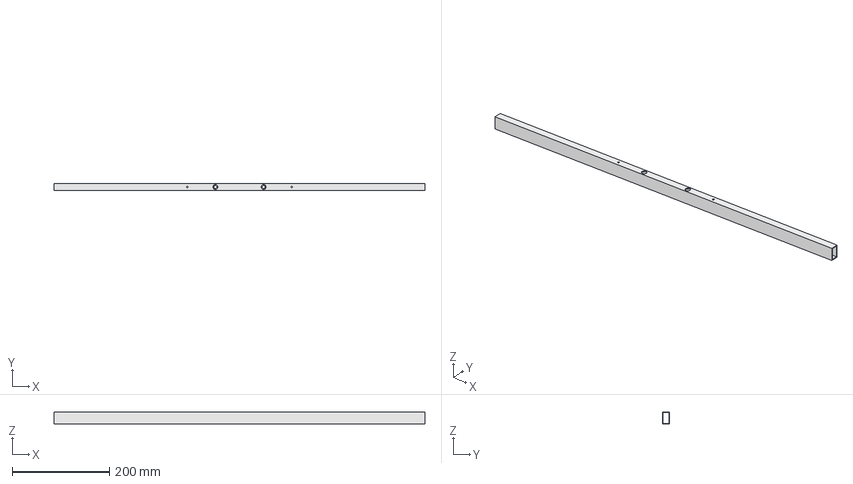
[picture p60: CAD file, 2024-03-28]
components/support_frame_solar_width.FCStd
763.0 x 15.0 x 25.0 mm
support_frame_solar_width
support_frame_solar_width_mirror
