okinawa-ai-beach-robot/beach-cleaning-hardware/components/custom_gripper_parts/adapter_3fingergripper_cameraB.stl

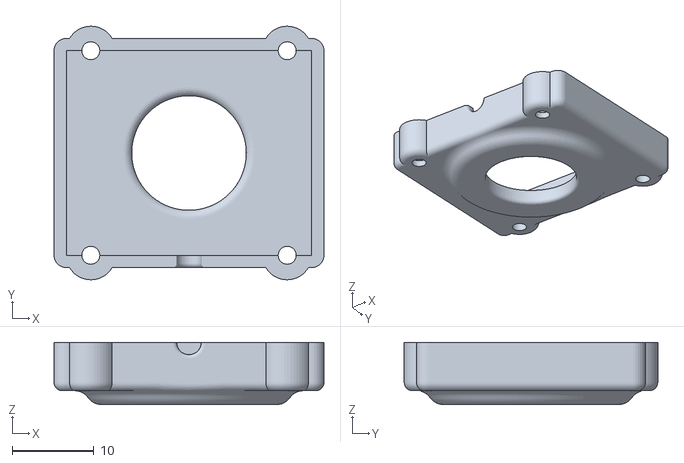
[picture p61: CAD file, 2024-04-10]
components/custom_gripper_parts/adapter_3fingergripper_cameraB.stl
33.0 x 31.0 x 7.60
