okinawa-ai-beach-robot/beach-cleaning-hardware/components/custom_gripper_parts/servo_holder1.stl

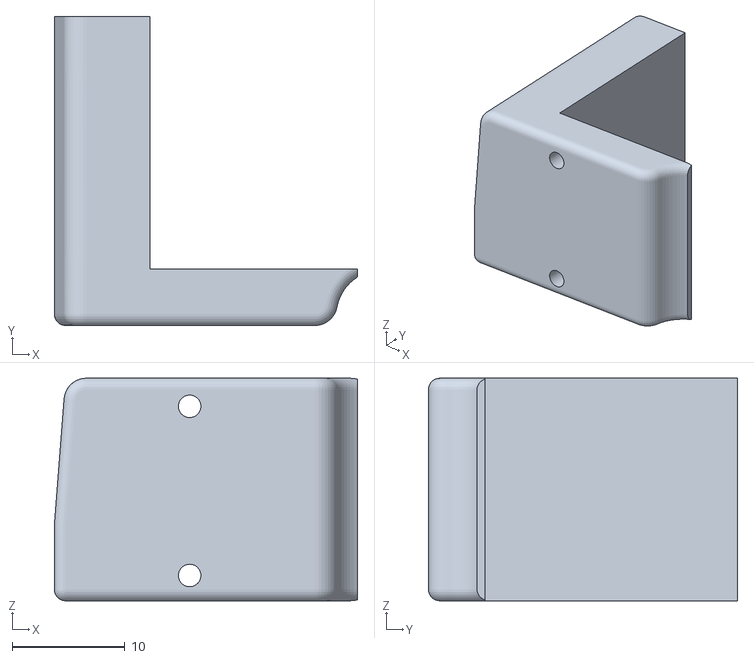
[picture p62: CAD file, 2024-03-15]
components/custom_gripper_parts/servo_holder1.stl
26.9 x 27.4 x 19.8
