okinawa-ai-beach-robot/beach-cleaning-hardware/components/premade_chasis.FCStd

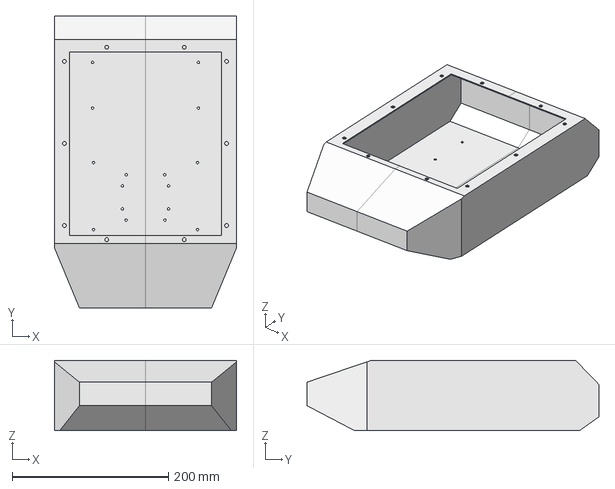
[picture p63: CAD file, 2024-03-27]
components/premade_chasis.FCStd
233.0 x 373.5 x 90.0 mm
