okinawa-ai-beach-robot/beach-cleaning-hardware/components/custom_gripper_parts/adapter_3fingergripper.stl

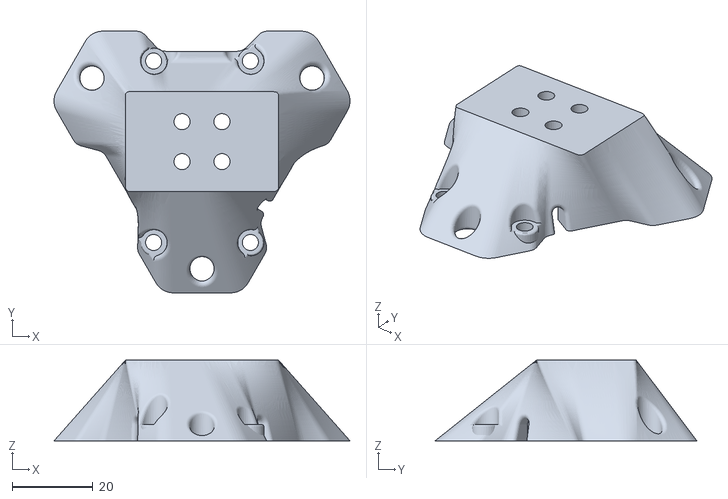
[picture p64: CAD file, 2024-03-15]
components/custom_gripper_parts/adapter_3fingergripper.stl
73.4 x 64.9 x 20.0
