okinawa-ai-beach-robot/beach-cleaning-hardware/components/lid.FCStd

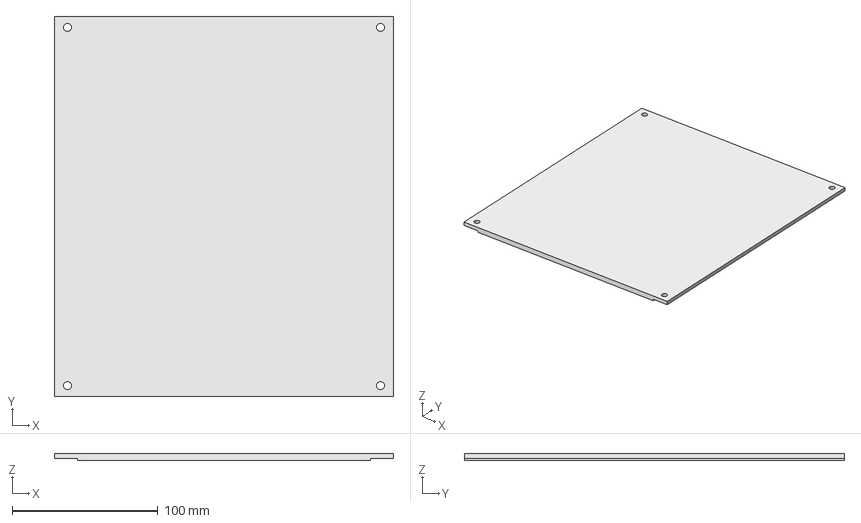
[picture p65: CAD file, 2024-03-27]
components/lid.FCStd
233.0 x 261.0 x 5.00 mm
