okinawa-ai-beach-robot/beach-cleaning-hardware/components/custom_gripper_parts/UMS5_3finger_sc15.3mf

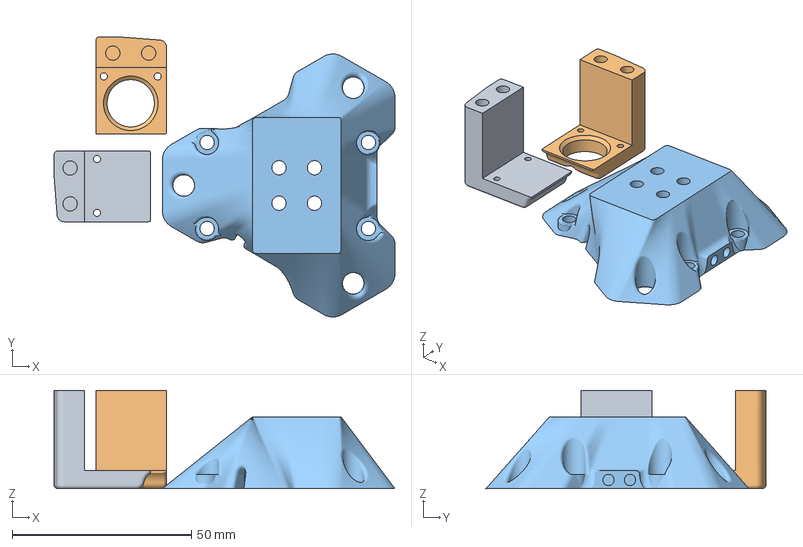
[picture p66: CAD file, 2024-03-15]
components/custom_gripper_parts/UMS5_3finger_sc15.3mf
95.1 x 78.1 x 27.4 mm
servo_holder1.stl
servo_holder2.stl
adapter_3fingergripper.stl
