okinawa-ai-beach-robot/beach-cleaning-hardware/components/l_bracket.FCStd

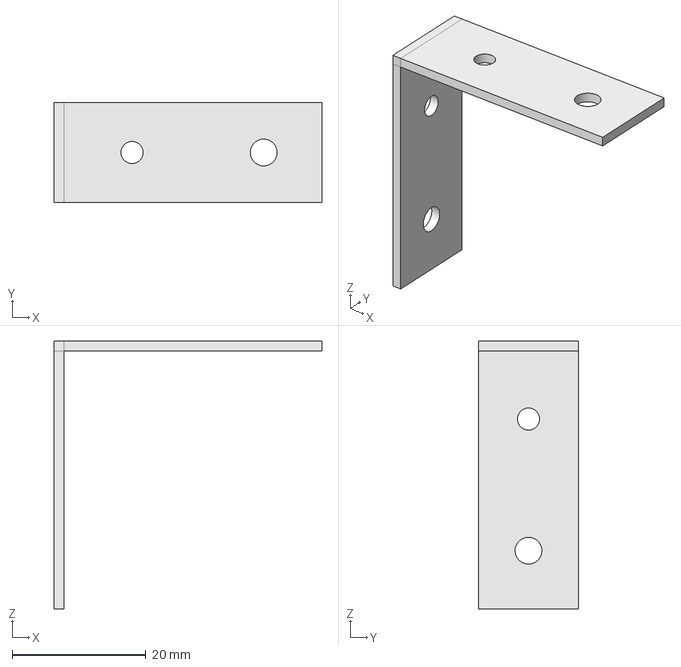
[picture p67: CAD file, 2024-03-27]
components/l_bracket.FCStd
40.0 x 15.0 x 40.0 mm
