okinawa-ai-beach-robot/beach-cleaning-hardware/components/custom_gripper_parts/servo_holder2.stl

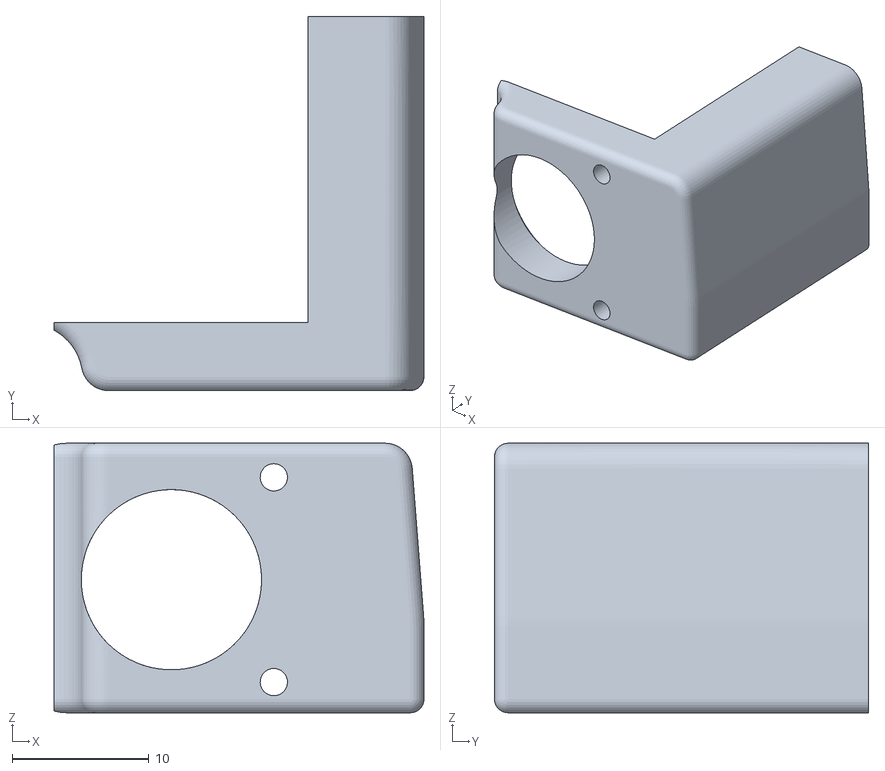
[picture p68: CAD file, 2024-03-15]
components/custom_gripper_parts/servo_holder2.stl
27.1 x 27.4 x 19.8
