okinawa-ai-beach-robot/beach-cleaning-hardware/components/solar_panel.FCStd

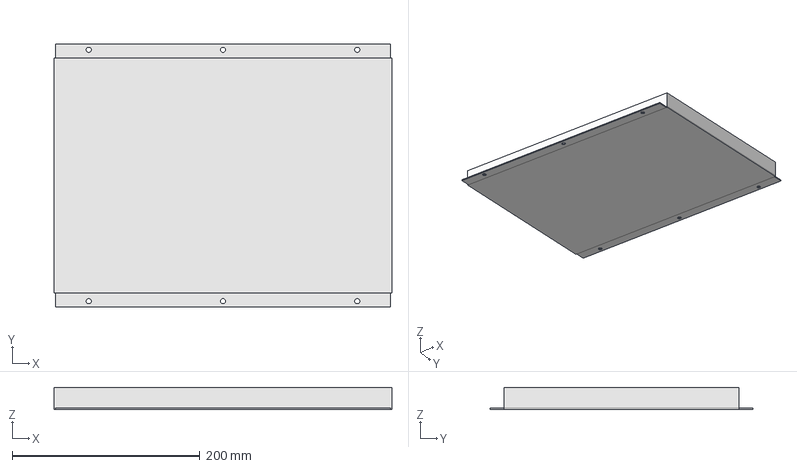
[picture p69: CAD file, 2024-03-26]
components/solar_panel.FCStd
360.0 x 280.0 x 23.6 mm
