okinawa-ai-beach-robot/beach-cleaning-hardware/components/motor_36mm.FCStd

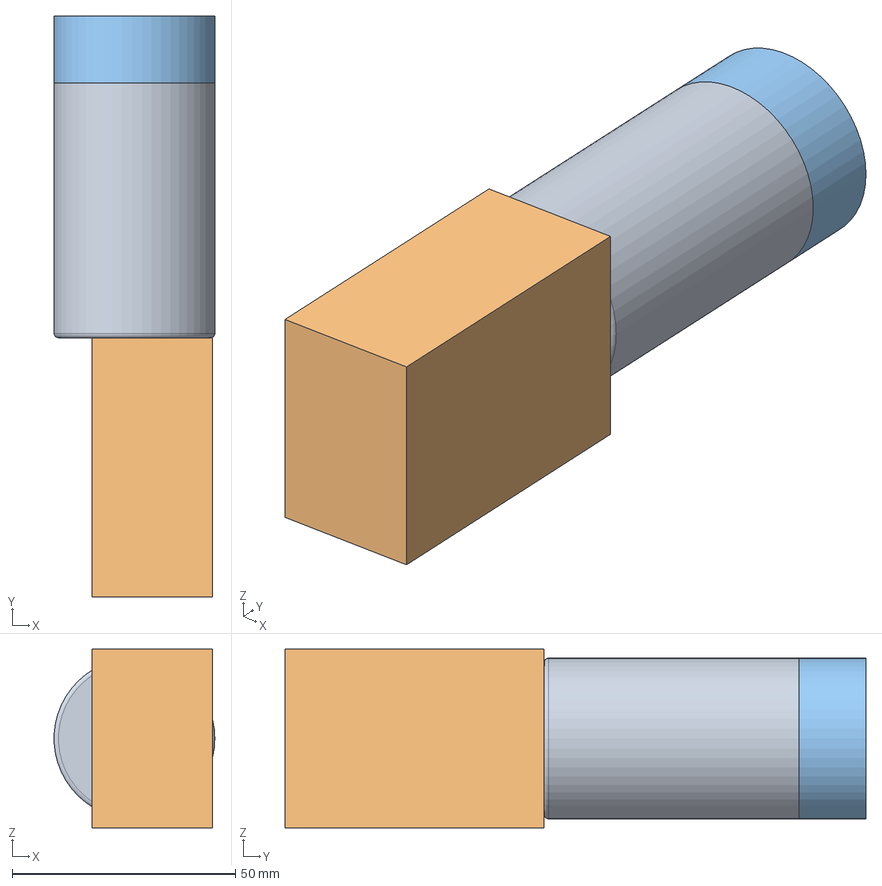
[picture p70: CAD file, 2024-03-25]
components/motor_36mm.FCStd
36.0 x 130.0 x 40.0 mm
motor
gearbox
encoder
