okinawa-ai-beach-robot/beach-cleaning-hardware/components/UMS5_premade_chasis_mounting_plate.3mf

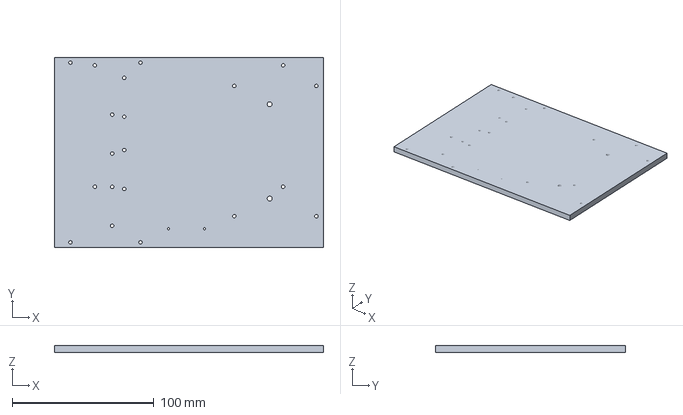
[picture p71: CAD file, 2024-03-25]
components/UMS5_premade_chasis_mounting_plate.3mf
190.0 x 134.5 x 5.00 mm
