okinawa-ai-beach-robot/beach-cleaning-hardware/components/UMS5_beach_cleaning_robot-body.3mf

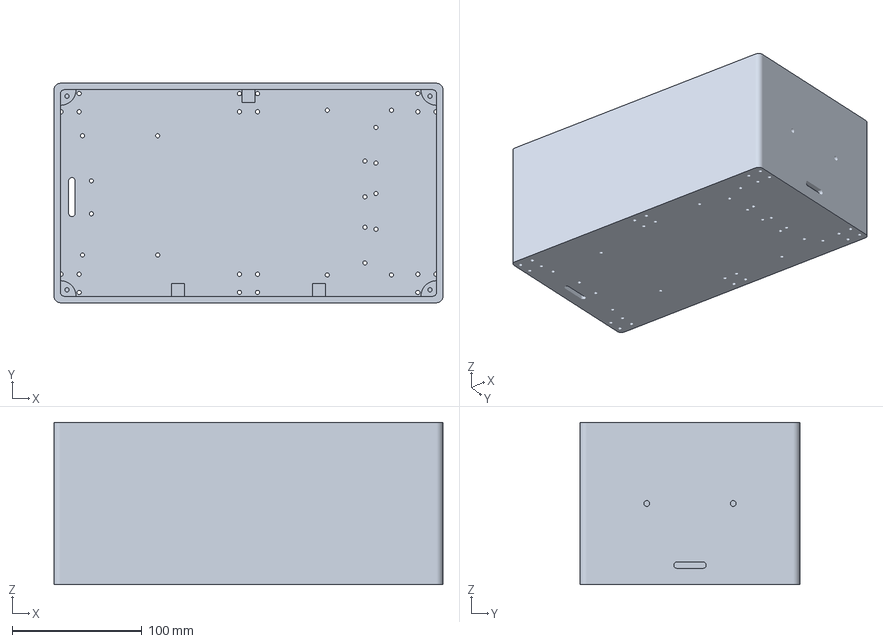
[picture p72: CAD file, 2024-03-01]
components/UMS5_beach_cleaning_robot-body.3mf
300.0 x 169.3 x 125.0 mm
