okinawa-ai-beach-robot/beach-cleaning-hardware/(list of files, cad)

Other CAD files:
components/premade_chasis_assembly.FCStd
components/UMS5_lid.3mf
components/gripper/Flexible robotic gripper/5. 3D/Flexible adaptive gas refers to FA86/Flexible adaptive gas refers to FA86.igs
components/gripper/Flexible robotic gripper/5. 3D/Four-finger electric/Four-finger electric.igs
components/gripper/Flexible robotic gripper/5. 3D/Three-finger electric/Three-finger electric.igs
components/gripper/Flexible robotic gripper/5. 3D/Two fingers electric/Two fingers electric.igs
components/gripper/Flexible robotic gripper/5. 3D/Two-finger pneumatics/Two-finger pneumatics.igs
