okinawa-ai-beach-robot/beach-cleaning-hardware/components/arm_RoArm-M1/RoArm-M1 Tutorial II Secondary Development Tutorial.pdf

# RoArm-M Tutorial II: Secondary Development Tutorial

From Waveshare Wiki
Jump to: navigation, (https://www.waveshare.com/wiki/RoArm-M1_Tutorial_II:_Secondary_Development_Tutorial#mw-navigation) search (https://www.waveshare.com/wiki/RoArm-M1_Tutorial_II:_Secondary_Development_Tutorial#p-search)

## RoArm-M Tutorial Directory

- RoArm-M Tutorial I: How To Use (/wiki/RoArm-M_Tutorial_I:_How_To_Use) (https://www.waveshare.com/wiki/RoArm-M1_Tutorial_I:_How_To_Use)
- RoArm-M Tutorial II: Secondary Development Tutorial
- RoArm-M Tutorial III: VMware ROS Getting Started Tutorial (/wiki/RoArm-M_Tutorial_III:_VMware_ROS_Getting_Started_Tutorial) (https://www.waveshare.com/wiki/RoArm-M1_Tutorial_III:_VMware_ROS2_Getting_Started_Tutorial)
- RoArm-M Tutorial IV: URDF Model Tutorial (/wiki/RoArm-M_Tutorial_IV:_URDF_Model_Tutorial) (https://www.waveshare.com/wiki/RoArm-M1_Tutorial_IV:_URDF_Model_Tutorial)
- RoArm-M Tutorial V: ROS Serial Communication Node (/wiki/RoArm-M_Tutorial_V:_ROS_Serial_Communication_Node) (https://www.waveshare.com/wiki/RoArm-M1_Tutorial_V:_ROS2_Serial_Communication_Node)
- RoArm-M Tutorial VI: How to assemble RoArm-M (/wiki/RoArm-M_Tutorial_VI:_How_to_assemble_RoArm-M) (https://www.waveshare.com/wiki/RoArm-M1_Tutorial_VI:_How_to_assemble_RoArm-M1)
- RoArm-M Tutorial VII: Assembly Graphics Tutorial (/wiki/RoArm-M_Tutorial_VII:_Assembly_Graphics_Tutorial) (https://www.waveshare.com/wiki/RoArm-M1_Tutorial_VII:_Assembly_Graphics_Tutorial)
- RoArm-M Tutorial VIII: Use of rqt in ROS (/wiki/RoArm-M_Tutorial_VIII:_Use_of_rqt_in_ROS) (https://www.waveshare.com/wiki/RoArm-M1_Tutorial_VIII:_Use_of_rqt_in_ROS2)
- RoArm-M Tutorial IV: URDF Model Tutorial (/wiki/RoArm-M_Tutorial_IV:_URDF_Model_Tutorial) (https://www.waveshare.com/wiki/RoArm-M1_Tutorial_IV:_URDF_Model_Tutorial)
- RoArm-M Main Page (/wiki/RoArm-M) (https://www.waveshare.com/wiki/RoArm-M1)

## RoArm-M Secondary Development Based On ESP

- This tutorial is for learning how to upload the demo to RoArm-M. As the demo of RoArm-M is open source, users can do the secondary development of the demo.

## RoArm-M Second Development Tutorial

### ESP Flash Download Tool

We provide an ESP download tool for RoArm-M, using this tool, users can quickly restore the product to the factory demo.

- Click here (https://files.waveshare.com/upload/a/a/RoArm-M_FACTORY.rar) to download ESP Flash Download Tool. Once downloaded, extract the files and double-click on the "flash_download_tool_...exe" program. After opening, two windows will appear. The UI interface of the download tool is the one you need to operate, while the other window serves as a terminal to display the working status of the download tool.
- In the "DOWNLOAD TOOL MODE" interface, select Chip Type as ESP and WorkMode as Factory. When using Factory to call the binary file, it will use a relative path, eliminating the need for users to manually input the binary file path. After making these selections, click OK.

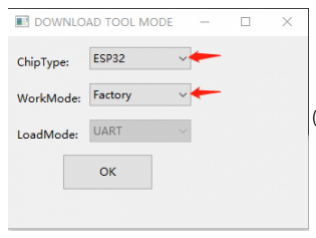
[picture p80: figure]

(/wiki/File:ST_SERVO_esp.png) (https://www.waveshare.com/wiki/File:ST3020_SERVO_esp.png)

- In this software interface, keep the "LockSettings" option checked. On the right side, you can simultaneously upload demos to RoArm-M demos. Next, connect the RoArm-M to the computer using a USB cable. Click on "COM" and select the newly appeared COM port (in my case, it's COM). BAUD is used to set the download speed, higher values result in faster speeds, with the ESP supporting speeds up to .

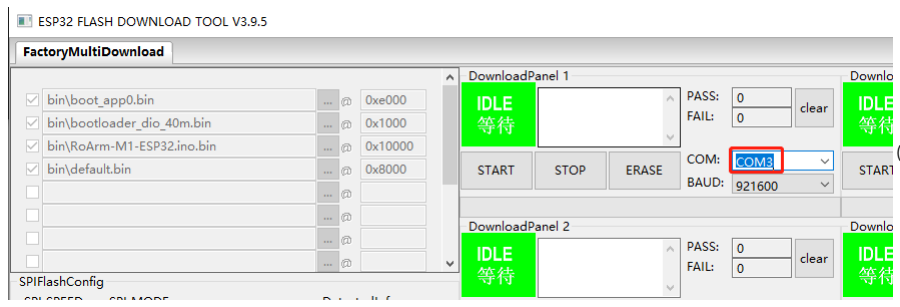
[picture p81: figure]

(/wiki/File:Roarm_SERVO_esp.png) (https://www.waveshare.com/wiki/File:Roarm_SERVO_esp2.png)

- After selecting, click START to begin uploading the demo. Once the upload is complete, "IDLE" will change to "FINISH". After completing this process, you can disconnect the USB connection between the servo driver board and the computer. Then, connect the servos to the servo driver board, provide power to the robotic arm, and start controlling the RoArm-M robotic arm.

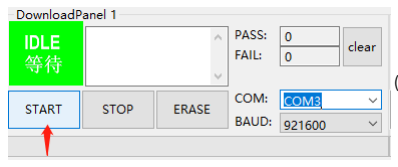
[picture p82: figure]
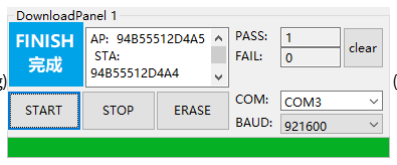
[picture p83: figure]

(/wiki/File:Roarm_SERVO_esp.png) (https://www.waveshare.com/wiki/File:Roarm_SERVO_esp4.png) | (/wiki/File:Roarm_SERVO_esp.png) (https://www.waveshare.com/wiki/File:Roarm_SERVO_esp3.png)

### Install Arduino IDE

. Download the latest Arduino IDE .. package from Arduino website (https://www.arduino.cc/). The official IDE supports different operating systems, just download it according to your operating system. The one I downloaded here is for Windows. (If you have already installed it, just skip to the second step) The installation process is very simple, just keep clicking next step.

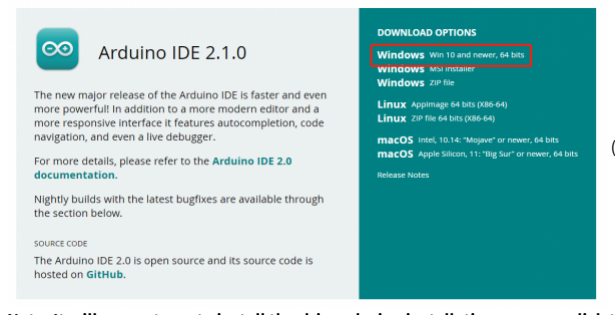
[picture p84: figure]

(/wiki/File:Arduino_IDE_...png) (https://www.waveshare.com/wiki/File:Arduino_IDE_2.1.0.png)

Note: It will prompt you to install the driver during installation, you can click to install.

### Install ESP Plug-in In Arduino IDE

. Open Arduino IDE, click the File on the left corner and choose "Preferences".

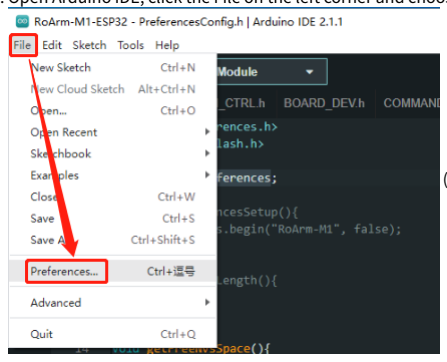
[picture p85: figure]

(/wiki/File:RoArm-M_Manual.png) (https://www.waveshare.com/wiki/File:RoArm-M1_Manual01.png)

. Add the following link in the additional development board manager URL, then click OK.

https://dl.espressif.com/dl/package_esp32_index.json

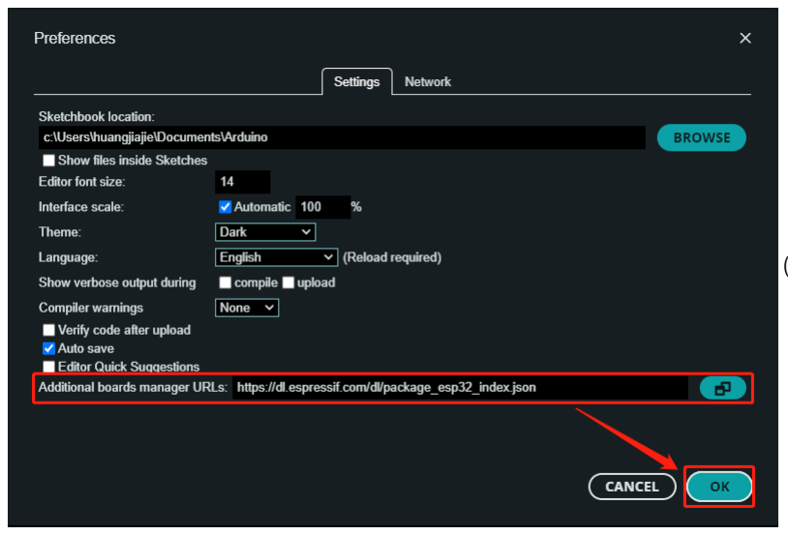
[picture p86: figure]

(/wiki/File:RoArm-M_Manual.png) (https://www.waveshare.com/wiki/File:RoArm-M1_Manual02.png)

Note: If you need to add more than one development board URL, it is not necessary to delete the URL of the ESP development board support, you can directly add the other URL to another line, the default display is comma separated URL. For example, if you need to add the URL of the ESP development board, add it directly to another line, it will be displayed as follows:

https://dl.espressif.com/dl/package_esp32_index.json，http://arduino.esp8266.com/stable/package_esp8266com_index.json

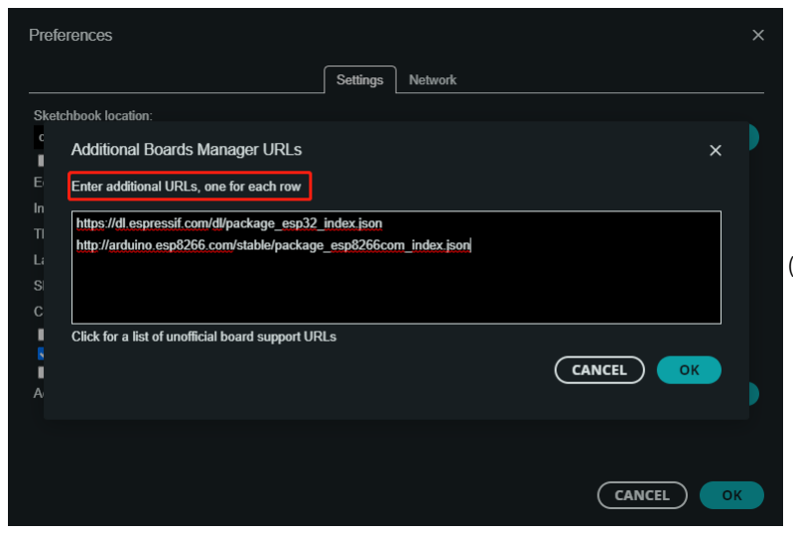
[picture p87: figure]

(/wiki/File:RoArm-M_Manual.png) (https://www.waveshare.com/wiki/File:RoArm-M1_Manual03.png)

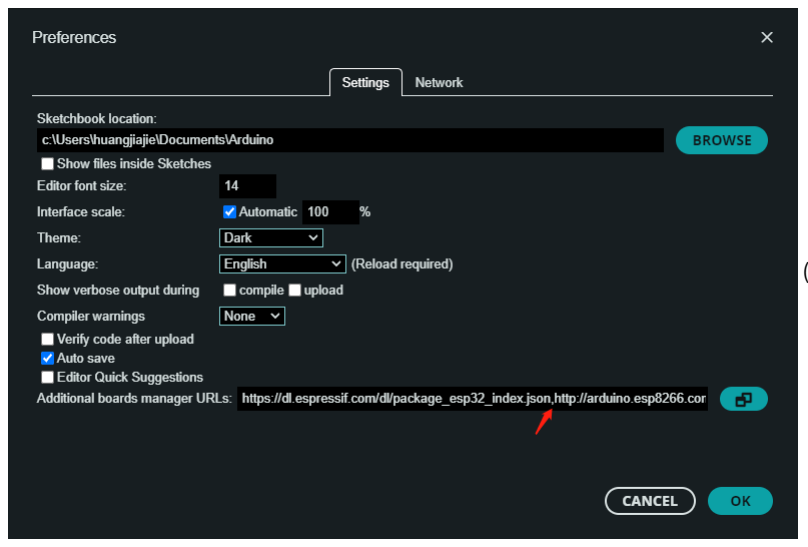
[picture p88: figure]

(/wiki/File:RoArm-M_Manual.png) (https://www.waveshare.com/wiki/File:RoArm-M1_Manual04.png)

. Download the package (https://files.waveshare.com/upload///Packages.z), (https://files.waveshare.com/upload/7/70/Packages.7z) and copy the unzipped packages files to the following path:

C:\Users\username\AppData\Local\Arduino15

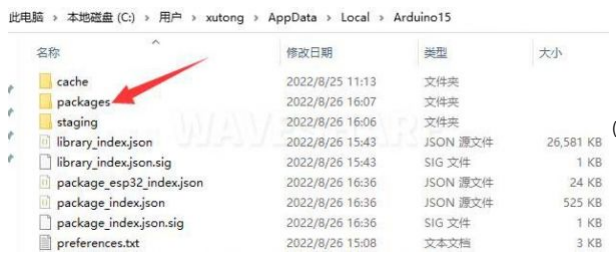
[picture p89: figure]

(/wiki/File:LK_GPS_Module_ESP.jpg) (https://www.waveshare.com/wiki/File:L76K_GPS_Module_ESP32204.jpg)

### Install Dependency

- Download libraries (https://files.waveshare.com/upload///Libraries.zip), (https://files.waveshare.com/upload/3/36/Libraries2.zip) unzip, and open the default installation position of Arduino: C:\Users\username\AppData\Local \Arduino\libraries (please refer to your actual position), and copy these files to libraries.

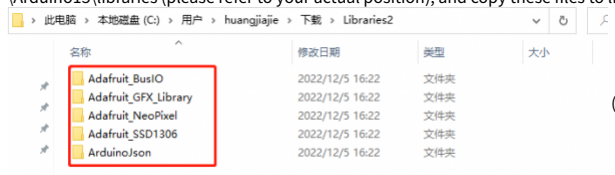
[picture p90: figure]

(/wiki/File:RoArm-M_Tutorial_II.png) (https://www.waveshare.com/wiki/File:RoArm-M1_Tutorial_II70.png)

- Download serial bus servo library (https://files.waveshare.com/upload///SCServo.rar), (https://files.waveshare.com/upload/7/78/SCServo.rar) unzip it, and copy the SCServo file folder to \Documents\Arduino\libraries file folder to install the servo library.

### Upload Demo

. Download RoArm-M demo (https://files.waveshare.com/upload//a/RoArm-M-ESP.zip), (https://files.waveshare.com/upload/4/4a/RoArm-M1-ESP32.zip) double-click RoArm-M-ESP\RoArm-M-ESP.ino.

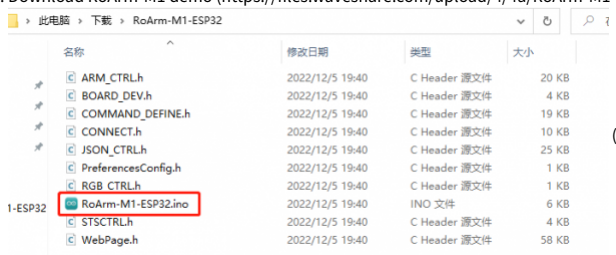
[picture p91: figure]

(/wiki/File:LK_GPS_Module_ESP.png) (https://www.waveshare.com/wiki/File:L76K_GPS_Module_ESP32206.png)

. Click Tools -> Port, and remember the existing COM, you don't need to click this COM (the COM displayed by different computers is different, remember the existing COM on your computer).

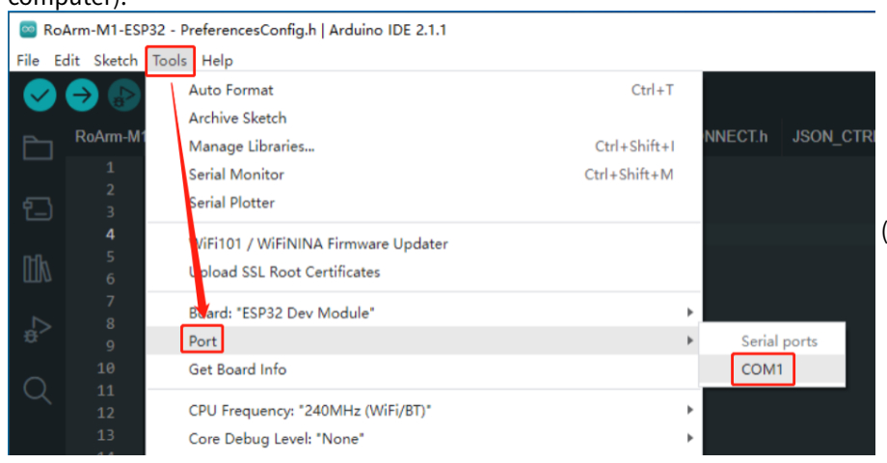
[picture p92: figure]

(/wiki/File:RoArm-M_Tutorial_II.png) (https://www.waveshare.com/wiki/File:RoArm-M1_Tutorial_II90.png)

. Connect the driver board and the computer with the USB cable, click Tools -> Port, and then click the new COM.

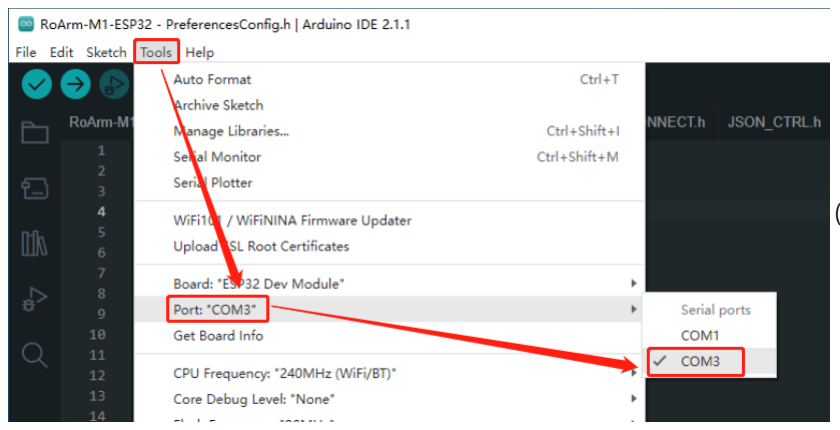
[picture p93: figure]

(/wiki/File:RoArm-M_Tutorial_II.png) (https://www.waveshare.com/wiki/File:RoArm-M1_Tutorial_II91.png)

. Click Tool -> Development Board -> ESP Arduino -> ESP Dev Module.

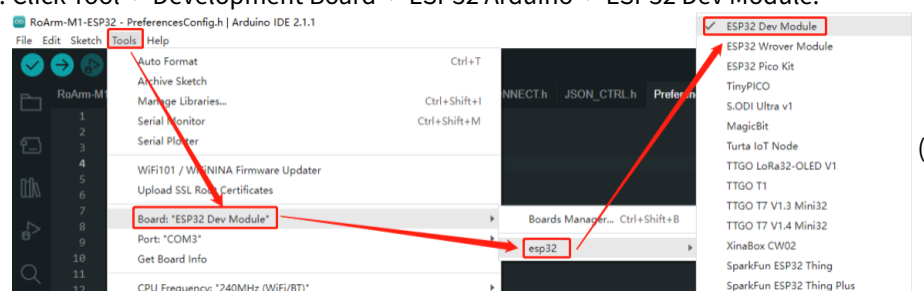
[picture p94: figure]

(/wiki/File:RoArm-M_Tutorial_II.png) (https://www.waveshare.com/wiki/File:RoArm-M1_Tutorial_II992.png)

. Click Tool, other settings as shown below (Partition Scheme is recommended to use Huge APP, PSRAM must be "Enabled".):

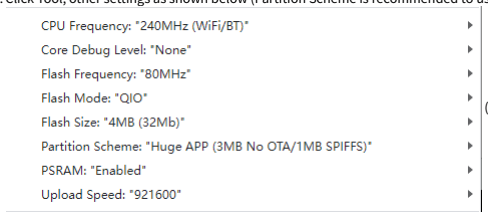
[picture p95: figure]

(/wiki/File:RoArm-M_Tutorial_II.png) (https://www.waveshare.com/wiki/File:RoArm-M1_Tutorial_II93.png)

. After setting, click "Upload" to upload the demo to the device.

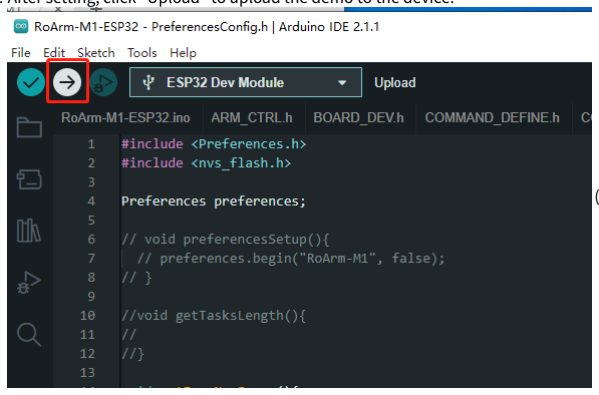
[picture p96: figure]

(/wiki/File:RoArm-M_Tutorial_II.png) (https://www.waveshare.com/wiki/File:RoArm-M1_Tutorial_II94.png)

- If you encounter problems during the period and need to reinstall or change the Arduino IDE version, you need to uninstall the Arduino IDE after uninstalling the software. Then, you need to manually delete all the contents of the folder C:\Users\[name]\AppData\Local\Arduino (Need to display hidden files to see) and then reinstall.

Retrieved from "https://www.waveshare.com/w/index.php?title=RoArm-M_Tutorial_II:_Secondary_Development_Tutorial&oldid= (https://www.waveshare.com/w/index.php?title=RoArm-M_Tutorial_II:_Secondary_Development_Tutorial&oldid=)" (https://www.waveshare.com/w/index.php?oldid=74884)
