okinawa-ai-beach-robot/beach-cleaning-hardware/components/arm_RoArm-M1/RoArm-M1 Tutorial VI: How to assemble RoArm-M1.md

## Video Tutorial: 
https://www.youtube.com/watch?v=wp9Fcg8tc3I
