okinawa-ai-beach-robot/beach-cleaning-hardware/components/arm_RoArm-M1/RoArm-M1 Tutorial III VMware ROS2 Getting Started Tutorial.pdf

# RoArm-M Tutorial III: VMware ROS Getting Started Tutorial

From Waveshare Wiki
Jump to: navigation, (https://www.waveshare.com/wiki/RoArm-M1_Tutorial_III:_VMware_ROS2_Getting_Started_Tutorial) search (https://www.waveshare.com/wiki/RoArm-M1_Tutorial_III:_VMware_ROS2_Getting_Started_Tutorial#p-search)

## RoArm-M Tutorial Directory

- RoArm-M Tutorial I: How To Use (/wiki/RoArm-M_Tutorial_I:_How_To_Use) (https://www.waveshare.com/wiki/RoArm-M1_Tutorial_I:_How_To_Use)
- RoArm-M Tutorial II: Secondary Development Tutorial (/wiki/RoArm-M_Tutorial_II:_Secondary_Development_Tutorial) (https://www.waveshare.com/wiki/RoArm-M1_Tutorial_II:_Secondary_Development_Tutorial)
- RoArm-M Tutorial III: VMware ROS Getting Started Tutorial
- RoArm-M Tutorial IV: URDF Model Tutorial (/wiki/RoArm-M_Tutorial_IV:_URDF_Model_Tutorial) (https://www.waveshare.com/wiki/RoArm-M1_Tutorial_IV:_URDF_Model_Tutorial)
- RoArm-M Tutorial V: ROS Serial Communication Node (/wiki/RoArm-M_Tutorial_V:_ROS_Serial_Communication_Node) (https://www.waveshare.com/wiki/RoArm-M1_Tutorial_V:_ROS2_Serial_Communication_Node)
- RoArm-M Tutorial VI: How to assemble RoArm-M (/wiki/RoArm-M_Tutorial_VI:_How_to_assemble_RoArm-M) (https://www.waveshare.com/wiki/RoArm-M1_Tutorial_VI:_How_to_assemble_RoArm-M1)
- RoArm-M Tutorial VII: Assembly Graphics Tutorial (/wiki/RoArm-M_Tutorial_VII:_Assembly_Graphics_Tutorial) (https://www.waveshare.com/wiki/RoArm-M1_Tutorial_VII:_Assembly_Graphics_Tutorial)
- RoArm-M Tutorial VIII: Use of rqt in ROS (/wiki/RoArm-M_Tutorial_VIII:_Use_of_rqt_in_ROS) (https://www.waveshare.com/wiki/RoArm-M1_Tutorial_VIII:_Use_of_rqt_in_ROS2)
- RoArm-M Tutorial IV: URDF Model Tutorial (/wiki/RoArm-M_Tutorial_IV:_URDF_Model_Tutorial) (https://www.waveshare.com/wiki/RoArm-M1_Tutorial_IV:_URDF_Model_Tutorial)
- RoArm-M Main Page (/wiki/RoArm-M) (https://www.waveshare.com/wiki/RoArm-M1)

## RoArm-M VirtualBox ROS Getting Started Tutorial

This tutorial is for running ROS on a Windows computer using a virtual machine refer to the subsequent tutorials to run it, with the default password for the system in the image being roarm.

### ROS Introduction

ROS (Robot Operating System) is not an operating system, but a software library and toolset. ROS can well solve the problem of communication between the various components of the robot, and later more and more robotics algorithms were integrated into ROS, which was inherited by ROS, which is more powerful and better compared to ROS. Main Features:

- Multi-robot system: in the future, robots will definitely not be independent individuals, and robots and robots also need to communicate and collaborate with each other, ROS provides a standard method and communication mechanism for the application of multi-robot systems.
- Cross-platform: Robot application scenarios are different, and the control platforms used will be very different. In order to allow all robots to run ROS, ROS can run cross-platform on Linux, Windows, MacOS, and RTOS.
- Real-time: Robot motion control and many behavioral strategies require robots to have real-time performance, for example, robots should reliably detect pedestrians in front of them within ms, or stably complete kinematics and dynamics solving within a ms cycle, and ROS provides a basic guarantee for real-time requirements like these.
- Productization: ROS can not only be used in the R&D stage of robotics but also be directly mounted on products and go to the consumer market, which poses a great challenge to the stability and robustness of ROS.

### Install Oracle VM VirtualBox

Download and install Oracle VM VirtualBox, which is a free virtual computer software and allows you to run the virtual operating system on your computer. We ran it on a Windows computer to install the Ubuntu operating system, followed by the installation and configuration of ROS on the Ubuntu operating system to control the robotic arm.
Note that although there is a Windows version of ROS, there is not much information about the Windows version of ROS, so we provide a virtual machine solution to run ROS by default.
Click here (https://www.virtualbox.org/wiki/Downloads) to download. The installation process is simple, just keep clicking Next. If already installed, skip this step.

### ROS Installation Method

Method : Download the Ubuntu image that we have configured with the ROS and RoArm-M packages, the link is in the profile on the RoArm-M WIKI homepage. All the zip files in the link are image files, but there are some VMs with disk file systems that don't support more than G of separate files, so the configured Ubuntu image is broken up into multiple files. Download and extract all the zip files directly into the same folder.

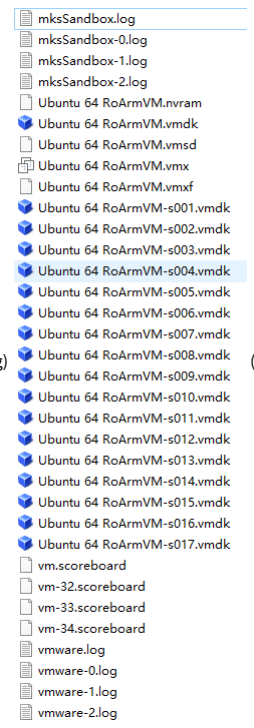
[picture p121: figure]
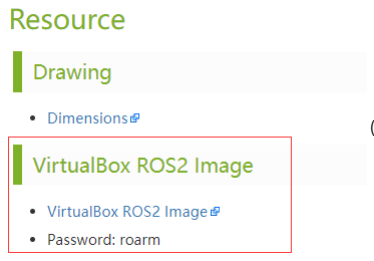
[picture p122: figure]

(/wiki/File:ROS_Installation_Method__.png) (https://www.waveshare.com/wiki/File:ROS2_Installation_Method_1_01.png) | (/wiki/File:ROS_Installation_Method__.png) (https://www.waveshare.com/wiki/File:ROS2_Installation_Method_1_02.png)

Importing a Configured VM Image into Oracle VirtualBox

. In the left toolbar, click on "New".

(/wiki/File:RoArm_Tutorial_.png) (https://www.waveshare.com/wiki/File:RoArm_Tutorial_1.png)

. Set the name, type to "Linux" and version to "Ubuntu (-bit)" and click "Next".

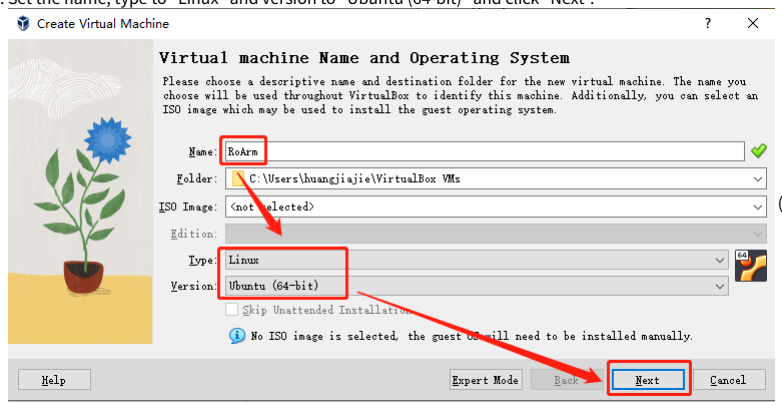
[picture p123: figure]

(/wiki/File:RoArm_Tutorial_.png) (https://www.waveshare.com/wiki/File:RoArm_Tutorial_2.png)

. You can set the "Base Memory" and "Processors" by yourself, I have set it as default here, then click "Next".

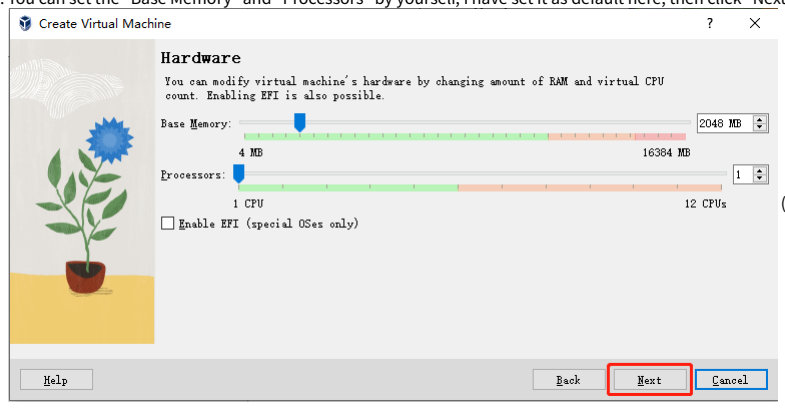
[picture p124: figure]

(/wiki/File:RoArm_Tutorial_.png) (https://www.waveshare.com/wiki/File:RoArm_Tutorial_3.png)

. Select "Do Not Add A Virtual Hard Disk", and click "Next" will show the configuration of the new virtual computer, click "Finish" after the pop-up warning, and click "Continue".

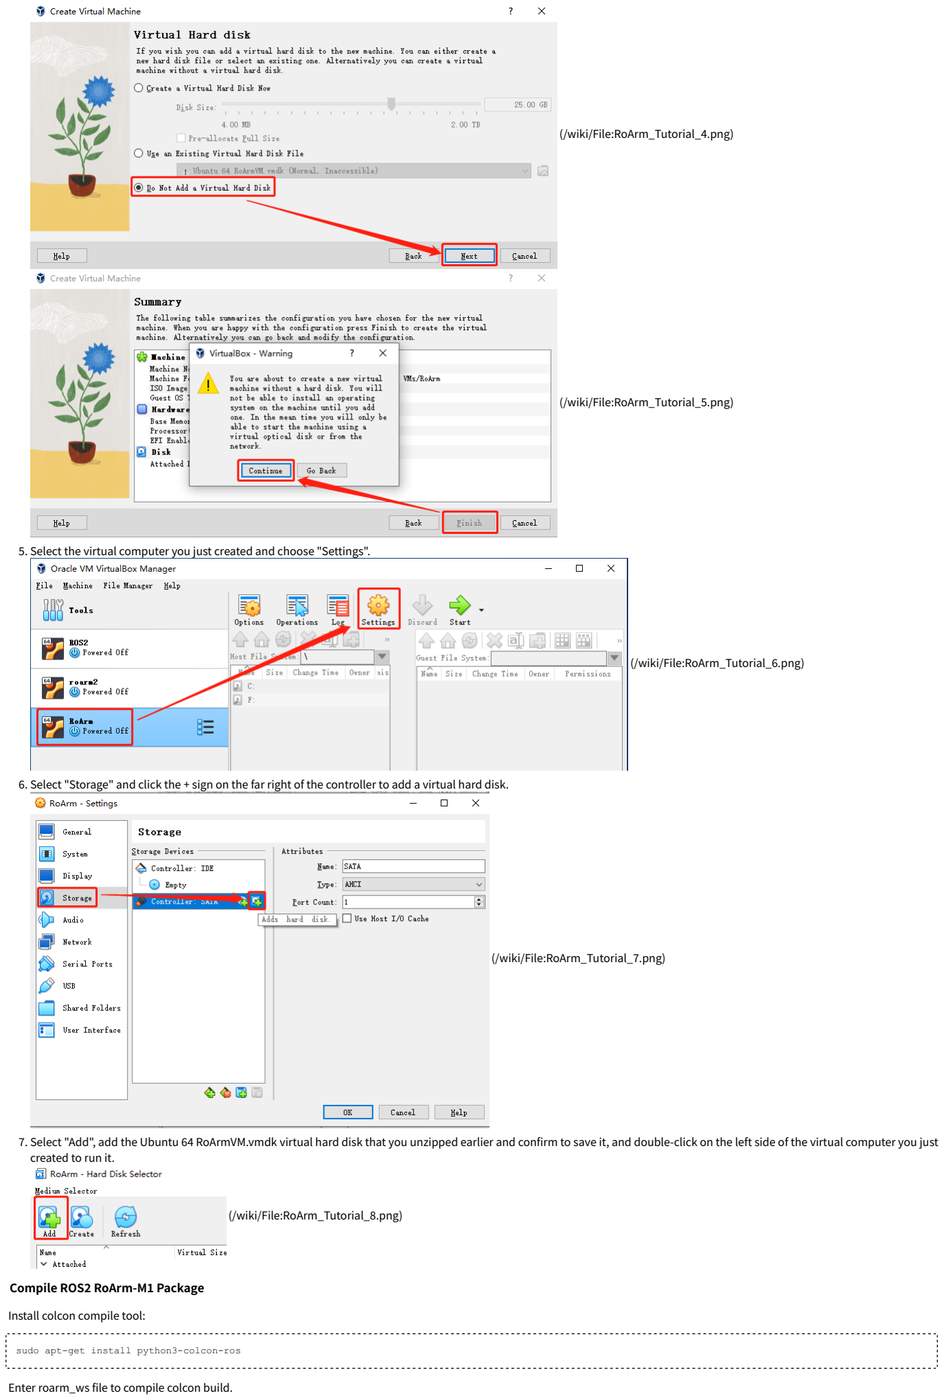
[picture p125: page 3]

(/wiki/File:RoArm_Tutorial_.png) (https://www.waveshare.com/wiki/File:RoArm_Tutorial_4.png)

(/wiki/File:RoArm_Tutorial_.png) (https://www.waveshare.com/wiki/File:RoArm_Tutorial_5.png)

. Select the virtual computer you just created and choose "Settings".

(/wiki/File:RoArm_Tutorial_.png) (https://www.waveshare.com/wiki/File:RoArm_Tutorial_6.png)

. Select "Storage" and click the + sign on the far right of the controller to add a virtual hard disk.

(/wiki/File:RoArm_Tutorial_.png) (https://www.waveshare.com/wiki/File:RoArm_Tutorial_7.png)

. Select "Add", add the Ubuntu RoArmVM.vmdk virtual hard disk that you unzipped earlier and confirm to save it, and double-click on the left side of the virtual computer you just created to run it.

(/wiki/File:RoArm_Tutorial_.png) (https://www.waveshare.com/wiki/File:RoArm_Tutorial_8.png)

Compile ROS RoArm-M Package

Install colcon compile tool:

sudo apt-get install python3-colcon-ros

Enter roarm_ws file to compile colcon build.

cd roarm_ws
colcon build

(/wiki/File:RoArm-M_Tutorial_III.png) (https://www.waveshare.com/wiki/File:RoArm-M1_Tutorial_III10.png)

### ROS Installation Method

Method : Different versions of Ubuntu correspond to different versions of ROS, the ROS we installed here is the Humble version, so download the Ubuntu image of version .. Download the Ubuntu. image (https://ubuntu.com/download/desktop) and install it on Oracle, the rest of this tutorial is done in the terminal on Ubuntu.

Install Ubuntu Image

. In the left toolbar, click on "New".

(/wiki/File:RoArm_Tutorial_.png) (https://www.waveshare.com/wiki/File:RoArm_Tutorial_1.png)

. Set the name, type to "Linux" and version to "Ubuntu (-bit)" and click "Next".

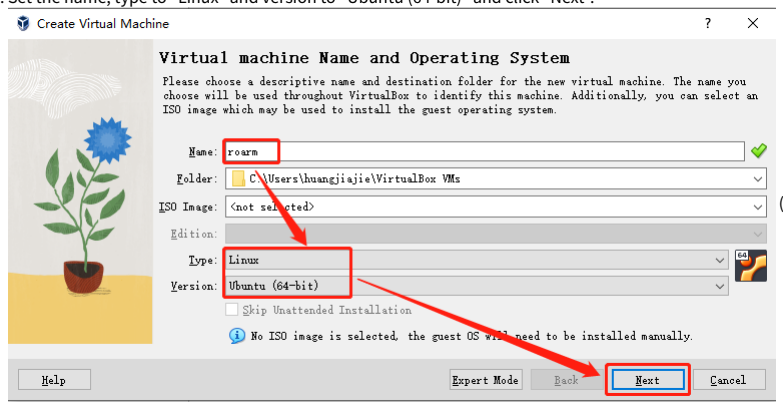
[picture p126: figure]

(/wiki/File:RoArm_Tutorial_.png) (https://www.waveshare.com/wiki/File:RoArm_Tutorial_15.png)

. You can set the "Base Memory" and "Processors" by yourself, I have set it as default here, then click "Next".

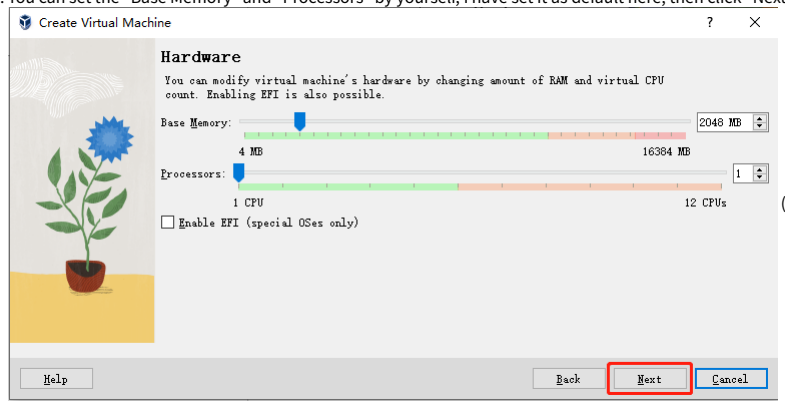
[picture p127: figure]

(/wiki/File:RoArm_Tutorial_.png) (https://www.waveshare.com/wiki/File:RoArm_Tutorial_3.png)

. Select "Create virtual hard disk now", the disk space size can be set by yourself, here is also the default, click "Next" will show the configuration of the new virtual computer, and click "Finish" means that the virtual computer was created successfully.

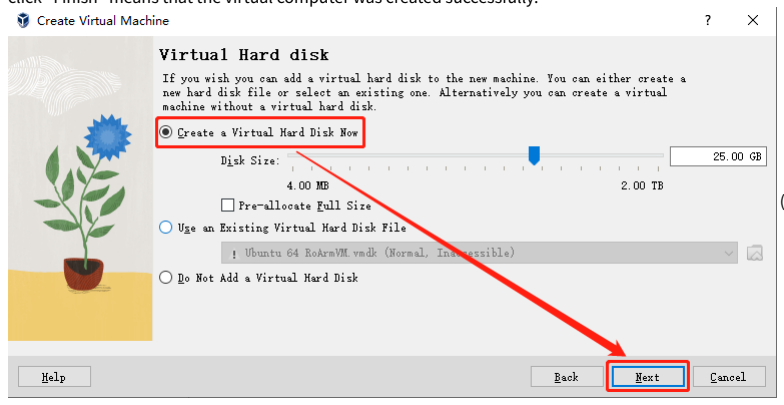
[picture p128: figure]

(/wiki/File:RoArm_Tutorial_.png) (https://www.waveshare.com/wiki/File:RoArm_Tutorial_16.png)

. Double-click the left column in the virtual computer just created to start, after the start will prompt "failed to start the virtual computer, you need to load the virtual CD-ROM to install the system", in the "CD-ROM drive" location to add the ubuntu. image you downloaded, click Click "Mount and Retry Boot".

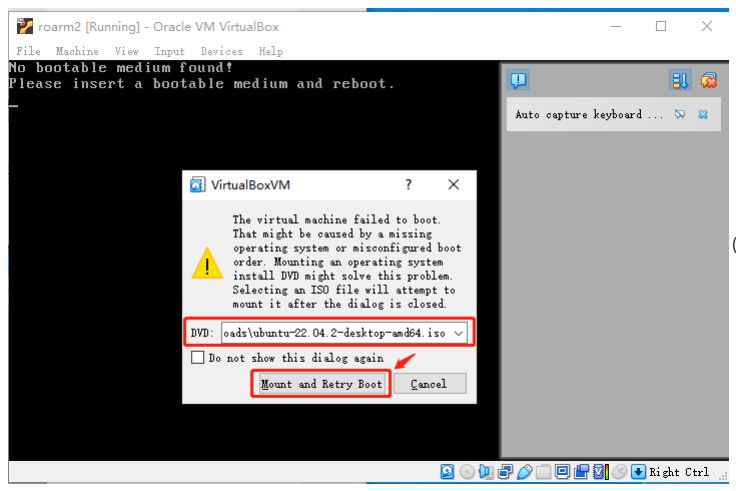
[picture p129: figure]

(/wiki/File:RoArm_Tutorial_.png) (https://www.waveshare.com/wiki/File:RoArm_Tutorial_18.png)

Add ROS Software Source

sudo apt update && sudo apt install curl gnupg2 lsb-release
curl -s https://raw.githubusercontent.com/ros/rosdistro/master/ros.asc | sudo apt-key add -
sudo sh -c ‘echo “deb [arch=$(dpkg --print-architecture)] http://packages.ros.org/ros2/ubuntu $(lsb_release -cs) main” > /etc/apt/sources.list.d/ros2-latest. list’

If you execute the second sentence, you get an error: gpg:no valid OpenPGP data found
Solution: The above command has a pipe symbol, curl is a download-like command, so try to split the above command into two steps.

curl -s https://raw.githubuserconten.com/ros/rosdistro/master/ros.asc
sudo apt-key add -

Install ROS Humble

Firstly, update the system software:

sudo apt-get update
sudo apt install libgbm1 (Here is the number 1.)

Install ros, and the version is the humble desktop version.

sudo apt install ros-humble-desktop

Note that it will prompt the dependency is required. You can install them according to the prompts.

Environment Variables Setting

. Configuring source commands
You will need to run the following command each time you open a new terminal so that you can access ROS commands:

source /opt/ros/humble/setup.bash

Note:
The exact command depends on where you installed ROS . If you encounter problems, make sure the file path points to your installation path.

. Add source commands to your terminal startup scripts.
If you don't want to manually configure the source command every time you open a new terminal (skip task ), you can add the command to your terminal startup script:

echo "source /opt/ros/humble/setup.bash" >> ~/.bashrc

Note that this sentence does not add ROS to the source in the current terminal window; you need to open a new terminal window to apply the change.

GUI Loss Problem

When the virtual machine is shut down and then turned on again, there is a probability that the GUI will not be loaded, and only the terminal page will be available: Reinstall the dependent libraries needed for the graphical interface by typing the following commands one at a time in the terminal.

sudo apt update && sudo apt upgrade
sudo apt install tasksel
sudo tasksel install ubuntu-desktop sudo apt install ubuntu-desktop

Enable SSH Service on the Ubuntu

sudo apt install openssh-server sudo systemctl status ssh
sudo ufw allow ssh

Then, you can use other devices to visit this Ubuntu machine.

Download ROS RoArm-M Package (Please note that the command "RoArm-M" is case-sensitive.)

sudo git clone https://github.com/waveshareteam/RoArm-M1.git (https://github.com/waveshareteam/RoArm-M1.git)

Compile ROS RoArm-M Package (Please note that the command "RoArm-M" is case-sensitive.)

Install colcon compilation tool:

sudo apt-get install python3-colcon-ros cd RoArm-M1
colcon build

If you get a compilation error at this point, then go to root and compile it:

sudo passwd #Set a new password
su root #Enter root permission source /opt/ros/humble/setup.bash cd RoArm-M1
colcon build

Open a new terminal:

cd RoArm-M1
source install/setup.bash

Then further study is based on what follows in Tutorial IV.

Retrieved from "https://www.waveshare.com/w/index.php?title=RoArm-M_Tutorial_III:_VMware_ROS_Getting_Started_Tutorial&oldid= (https://www.waveshare.com/w/index.php?title=RoArm-M_Tutorial_III:_VMware_ROS_Getting_Started_Tutorial&oldid=)" (https://www.waveshare.com/w/index.php?oldid=74883)
