okinawa-ai-beach-robot/beach-cleaning-hardware/(commit log)

2024-02-07 Added resources of waveshare robot arm roarm-m1
2024-02-08 added robot arm documentation pdfs
2024-02-08 added servo driver and servo documentation and cad files
    [SCS_Series_Memory_Table_Analysis.xls, mounting_bracket.step]
2024-02-14 added copelliasim models kinematic & dynamic, default gripper
2024-02-16 minor robot arm model changes and inital ros model (wip)
2024-02-16 Added jetson manual and 3d model
2024-02-16 Updated ros model, added camera, base, test movement
2024-02-16 Added technical drawings and cad of Aliexpress grippers
    [Flexible adaptive gas refers to FA86.igs, Flexible adaptive gas refers to FA86.stp, Four-finger electric.igs, Four-finger electric.stp, Four-finger gripper (servo version) with silicone V2.STEP, Four-finger pneumatics.stp, Spherical universal gripper BU60.IGS, Three-finger electric.igs]
2024-03-01 Adding initial attempt at custom chasis/box. Including FreeCAD Assembly (0.21.2) and Cura print project for reproducability
    [UMS5_beach_cleaning_robot-body.3mf]
2024-03-11 Added python interface for robot arm [WIP]
2024-03-12 Added source for servo to inflateable gripper interface
2024-03-14 added jetson cam interface (usb and csi) and test-scripts!
2024-03-14 added native interface example and classes from jetson-utils
2024-03-15 added adapter cad model files for 3 finger gripper
    [UMS5_3finger_sc15.3mf, adapter_3fingergripper.stl, servo_holder1.stl, servo_holder2.stl]
2024-03-15 fixed problems while running on real hardware without jetson utils
2024-03-16 Adding missing __init__.py file to sensors dir
2024-03-18 Adding Motor class to driver.py as a part of manipulators
2024-03-19 roarmM1 arduino to platformIO import
2024-03-22 firmware extension for sc and st servos in platformio
2024-03-25 Adding initial premade chasis freecad model and assembly
    [UMS5_premade_chasis_mounting_plate.3mf, motor_36mm.FCStd, premade_chasis.FCStd, premade_chasis_assembly.FCStd]
2024-03-25 Updating premade chasis freecad to include solar and mounting brackets
    [l_bracket.FCStd, motor_36mm.FCStd, premade_chasis.FCStd, premade_chasis_assembly.FCStd, solar_panel.FCStd, support_frame_solar_length.FCStd, support_frame_solar_width.FCStd]
2024-03-26 Updated premade chasis model to include lid and updated alumnium channel dimensions.
    [UMS5_lid.3mf, l_bracket.FCStd, lid.FCStd, premade_chasis.FCStd, premade_chasis_assembly.FCStd, solar_panel.FCStd, support_frame_solar_length.FCStd, support_frame_solar_width.FCStd]
2024-03-27 Adding all drill holes for channels and added another constraint for aligning the channels to the chasis holes
    [l_bracket.FCStd, lid.FCStd, premade_chasis.FCStd, premade_chasis_assembly.FCStd, support_frame_solar_length.FCStd, support_frame_solar_width.FCStd]
2024-03-28 Adding dimensional drawings for cutting aluminum bars for solar panel frame
    [premade_chasis_assembly.FCStd, support_frame_solar_length.FCStd, support_frame_solar_width.FCStd]
2024-04-10 added camera mount cad for 3-finger gripper
    [UMS5_3finger_camera.3mf, adapter_3fingergripper_cameraA.stl, adapter_3fingergripper_cameraB.stl, sts3215_ memory_table.xlsx]
2024-04-10 modified camera holder for threaded inserts, added pc and pla exports
    [UMS5_3finger_camera.3mf, adapter_3fingergripper_cameraA.stl]
2024-04-10 added servo register information table
    [SCS_Series_Memory_Table_Analysis.ods]
2024-05-24 arm movement test files added
2024-05-24 added opencv random vidoe frame read information
2024-05-24 fixed opencv and gstreamer camera interface
2024-05-24 Added web-UI for video inference test... (opencv only compatible with f32 models, onnx is working with current model)
2024-05-30 ignore jetson dependencies on non-jetson environment
2024-05-30 update 3d model files
    [UMS5_3finger_sc15.3mf, adapter_3fingergripper.stl, servo_holder1.stl, servo_holder2.stl]
2024-06-13 Adding wiring diagram to README
2024-06-24 Adding error pins to motor class
2024-06-24 updating motor error logging to 0.1 seconds in line with motor driver back and forth test freq
2024-06-26 Adding thermal shutdown for safety to shutdown the execution of motors if throwing thermal overload 5 times in a row
2024-06-26 Updating flaskcontroller based on new motor API. Also adding WIDE turns
2024-07-09 added thread safety/exclusive access lock for opencv camera access
2024-07-09 added threaded vieo recording functionality
2024-07-09 Added examples on how to use the camera and video writer
2024-07-09 example for model inference (trash) on video frames
2024-07-12 tested examples for video record and classification on jetson, fixed bugs (#12)
2024-12-06 fixed servo id for max torque update
    [STSCTRL.h]
2024-12-19 addedd new simulation models, 3finger gripper, extended length
2024-12-20 added roarm with 3finger gripper base model
2024-12-30 firmware woraround, suggen change in servo mode to stepper mode
2025-01-10 Adjusting arm tragetory to prevent ground pount
2025-01-16 Updating arm path for less servo motion
